ELERIX/elerix-cpm-pcb/ELERIX-CPM-Full-Image.png

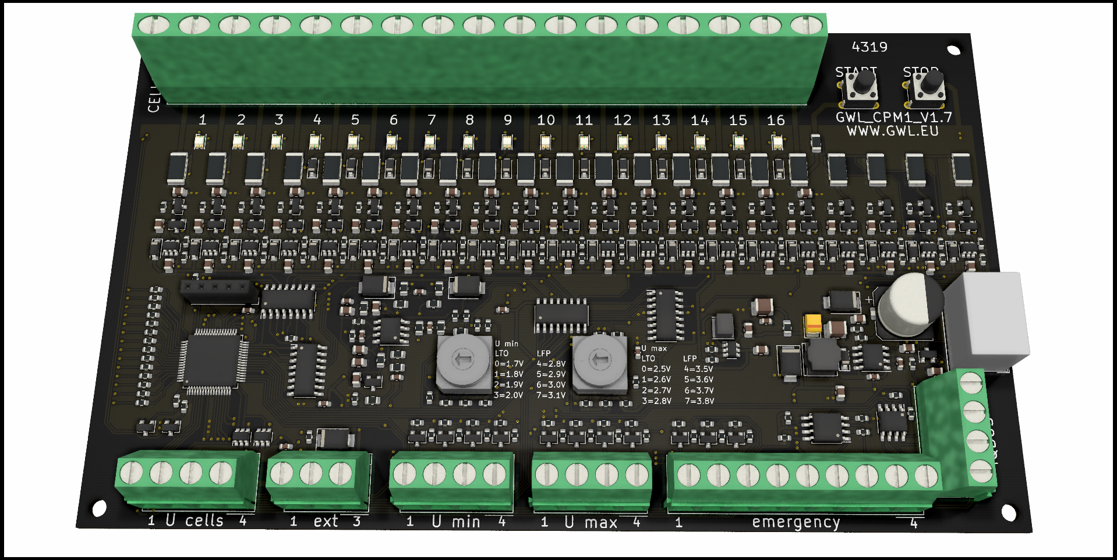
ELERIX-CPM-Full-Image.png
