ELERIX/elerix-cpm-pcb/README.md

# CPM PCB

Printed circuit board files

IDE: KiCad
