ELERIX/elerix-cpm-pcb/CE-conformity/ELERIX-CPM-EN-61000-6-4-2006-EMC-Emission.pdf

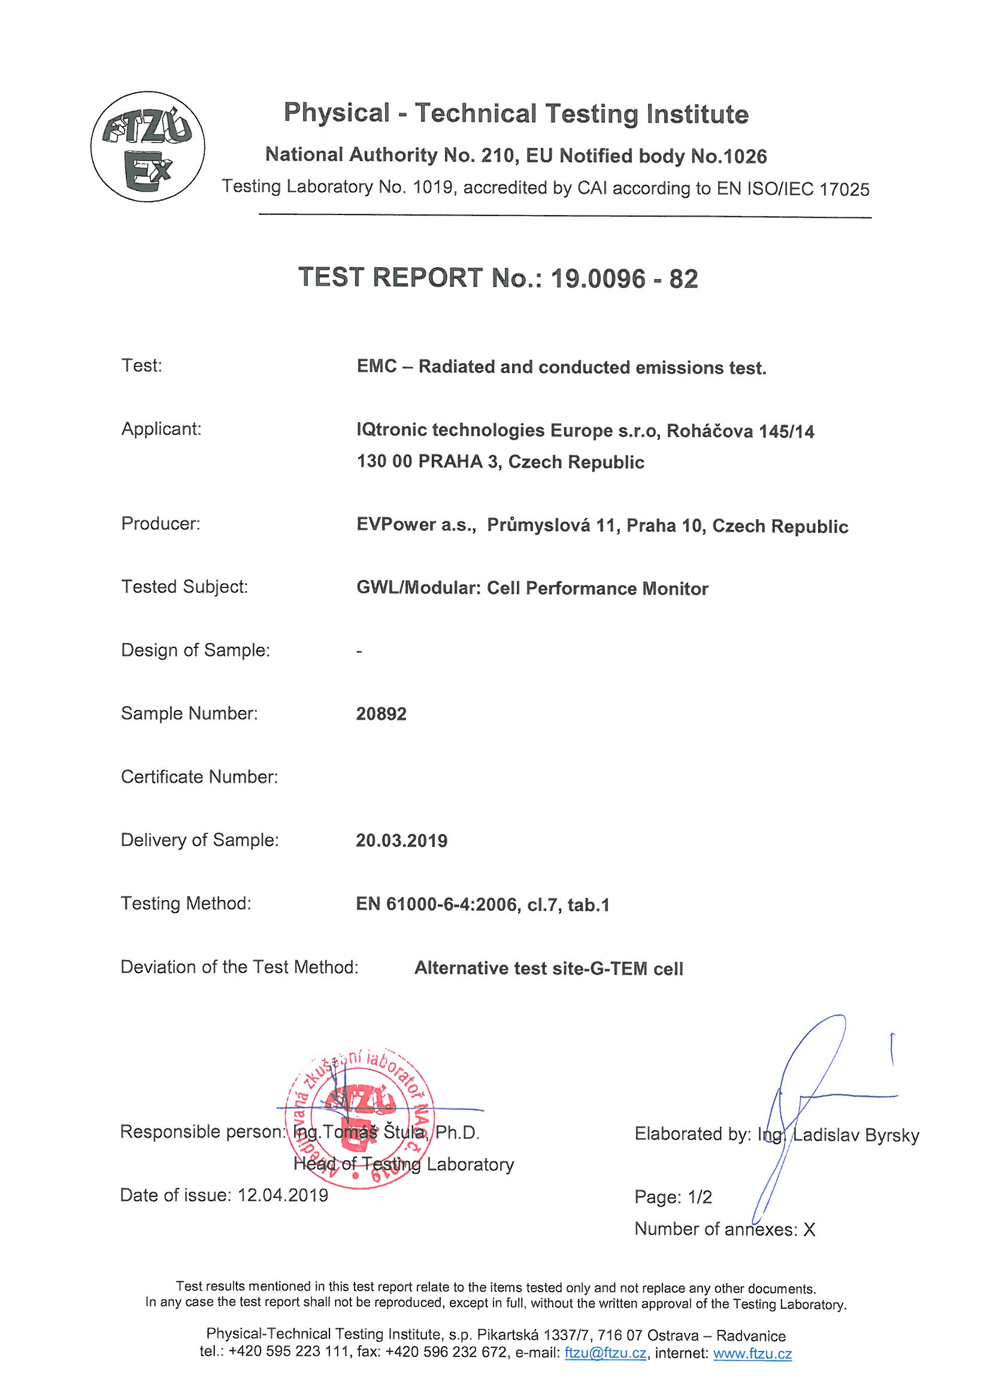
[picture p2: page 1]
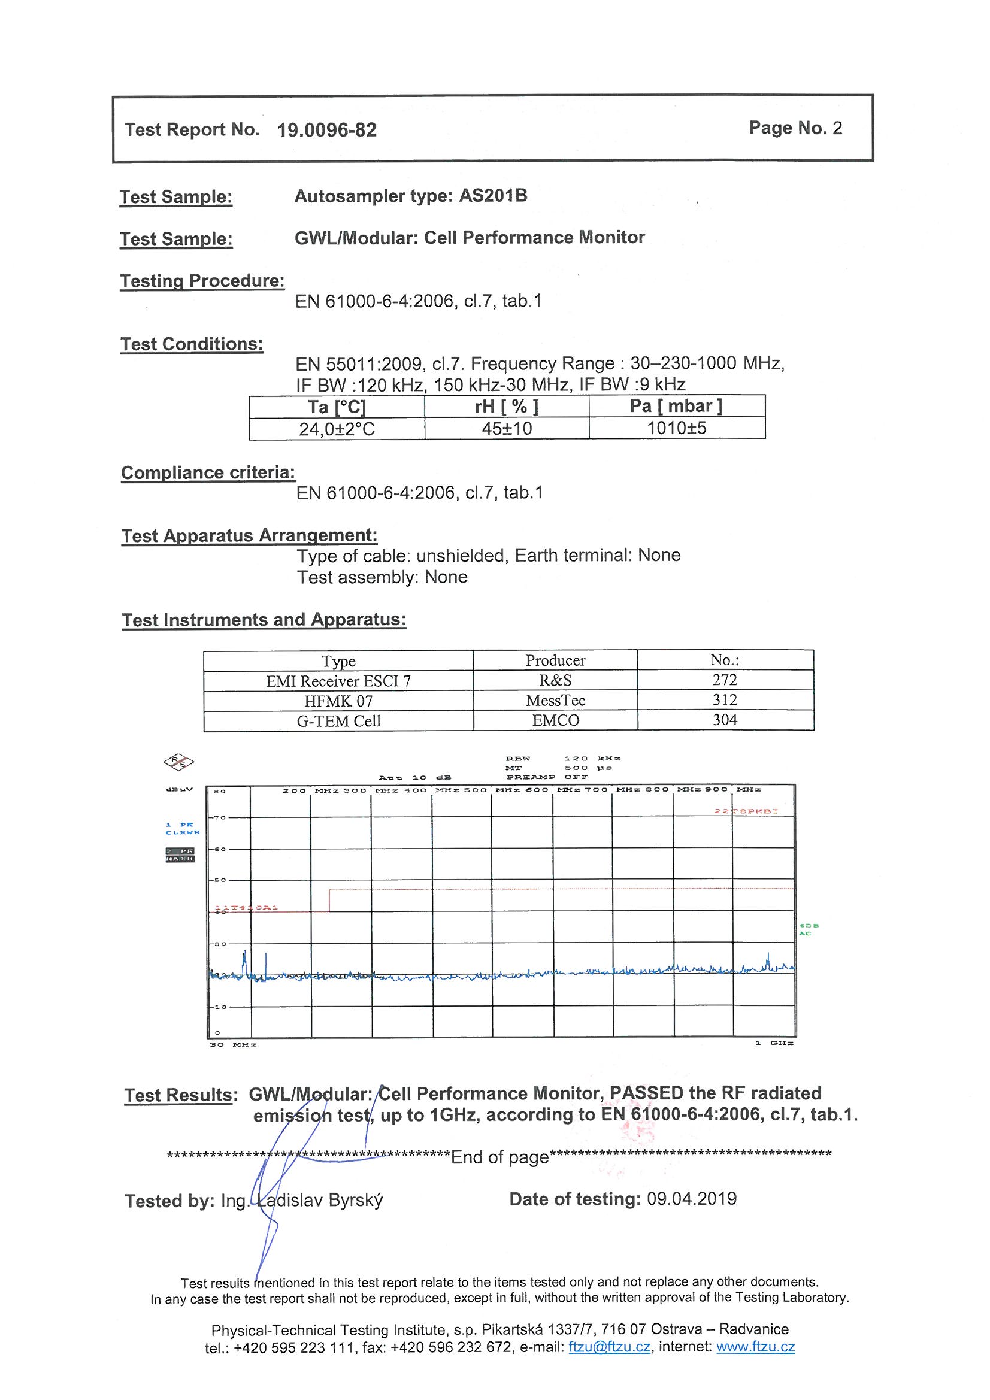
[picture p3: page 2]
