ELERIX/elerix-cpm-pcb/3D/Rotary Switch 8 positions.stp

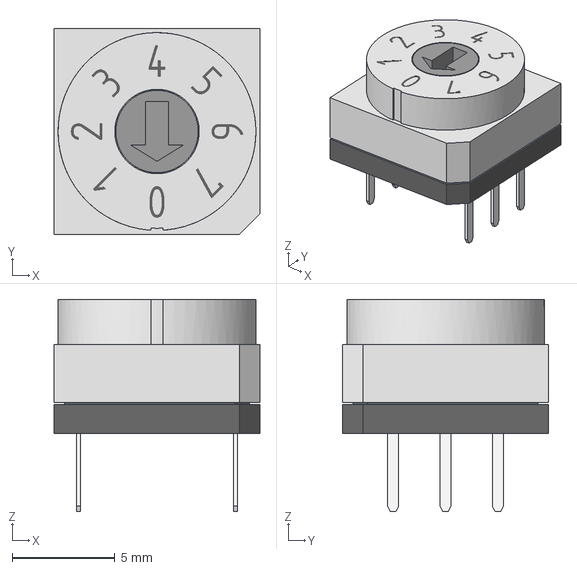
[picture p4: CAD file, 2021-03-24]
3D/Rotary Switch 8 positions.stp
10.0 x 10.0 x 10.3 mm
