ELERIX/elerix-cpm-pcb/3D/N4100CHS3DC6AC.step

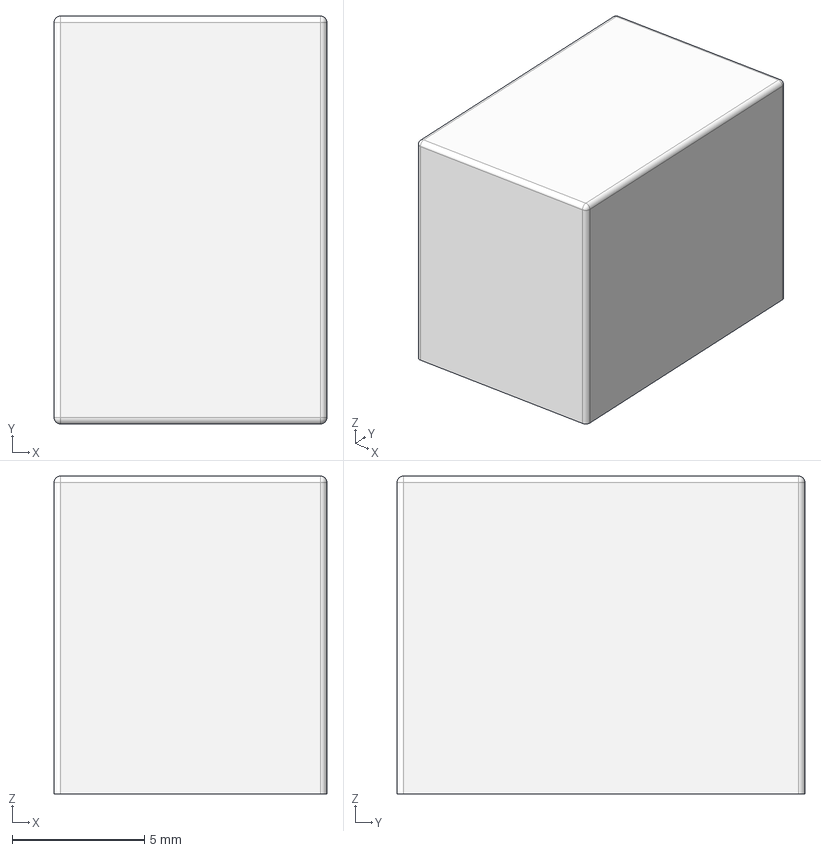
[picture p5: CAD file, 2021-03-24]
3D/N4100CHS3DC6AC.step
10.3 x 15.4 x 12.0 mm
