ELERIX/elerix-cpm-pcb/CE-conformity/ELERIX-CPM-EN-61000-4-3-2006-EMC-Immunity-Test.pdf

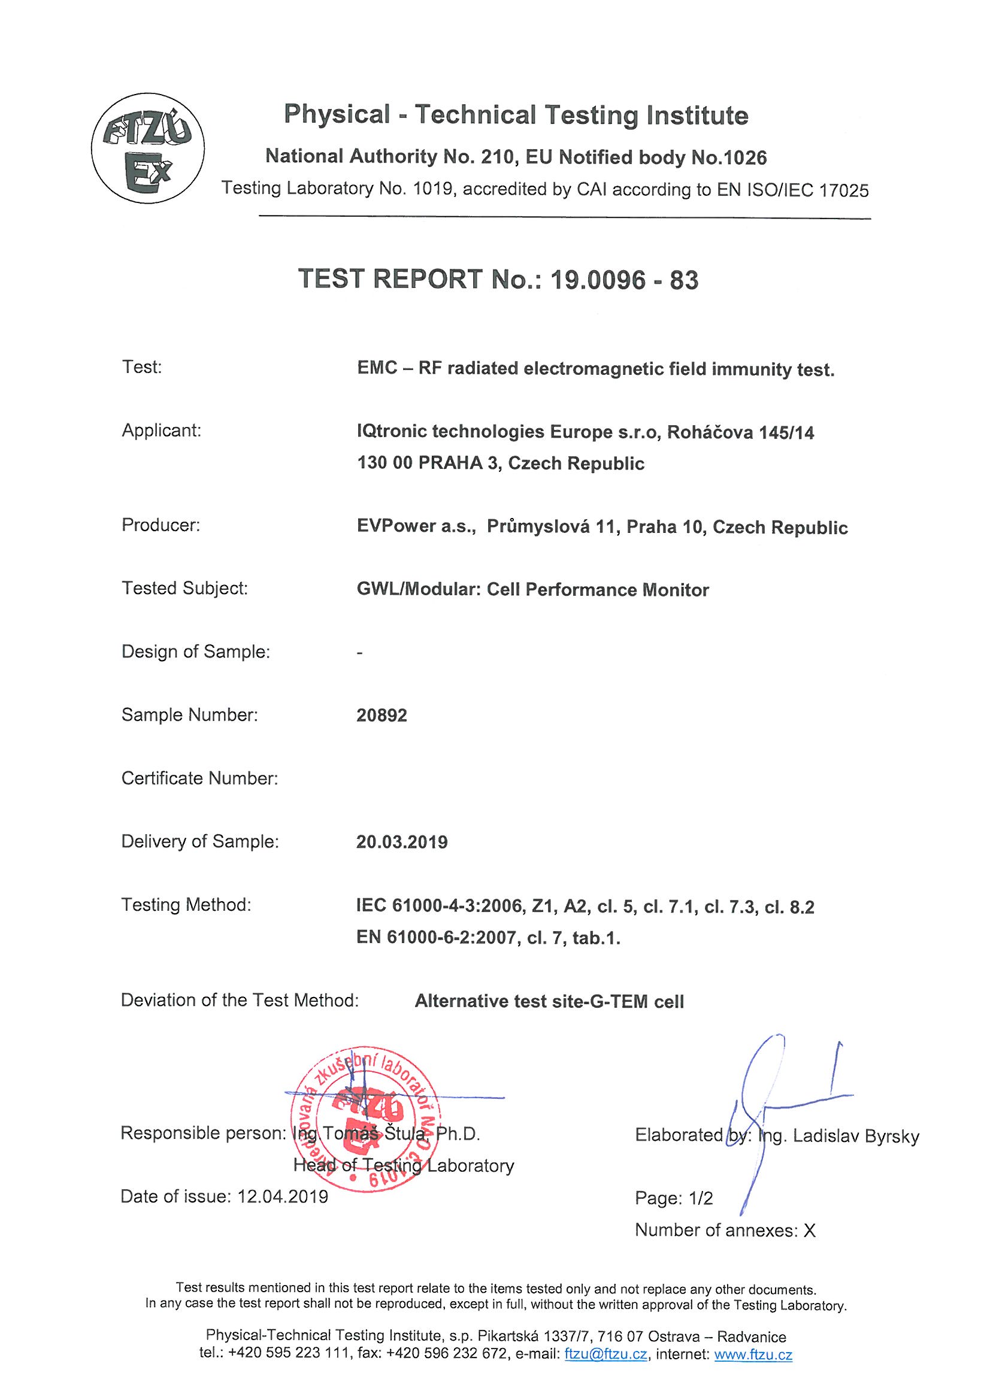
[picture p6: page 1]
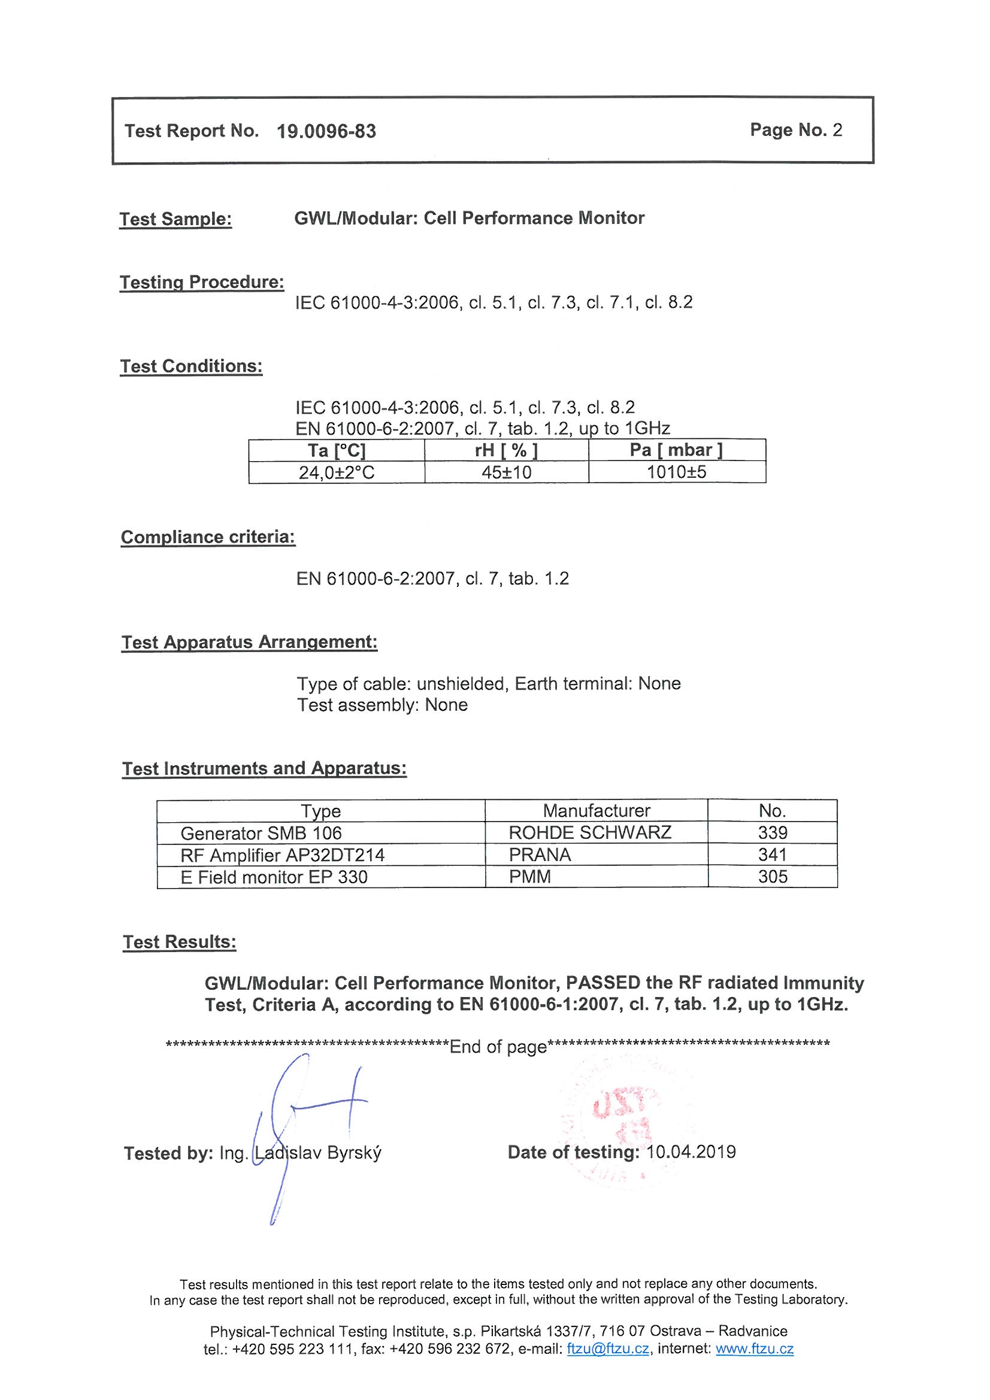
[picture p7: page 2]
