ELERIX/elerix-cpm-pcb/ELERIX-CPM_Complete-Schematic.pdf

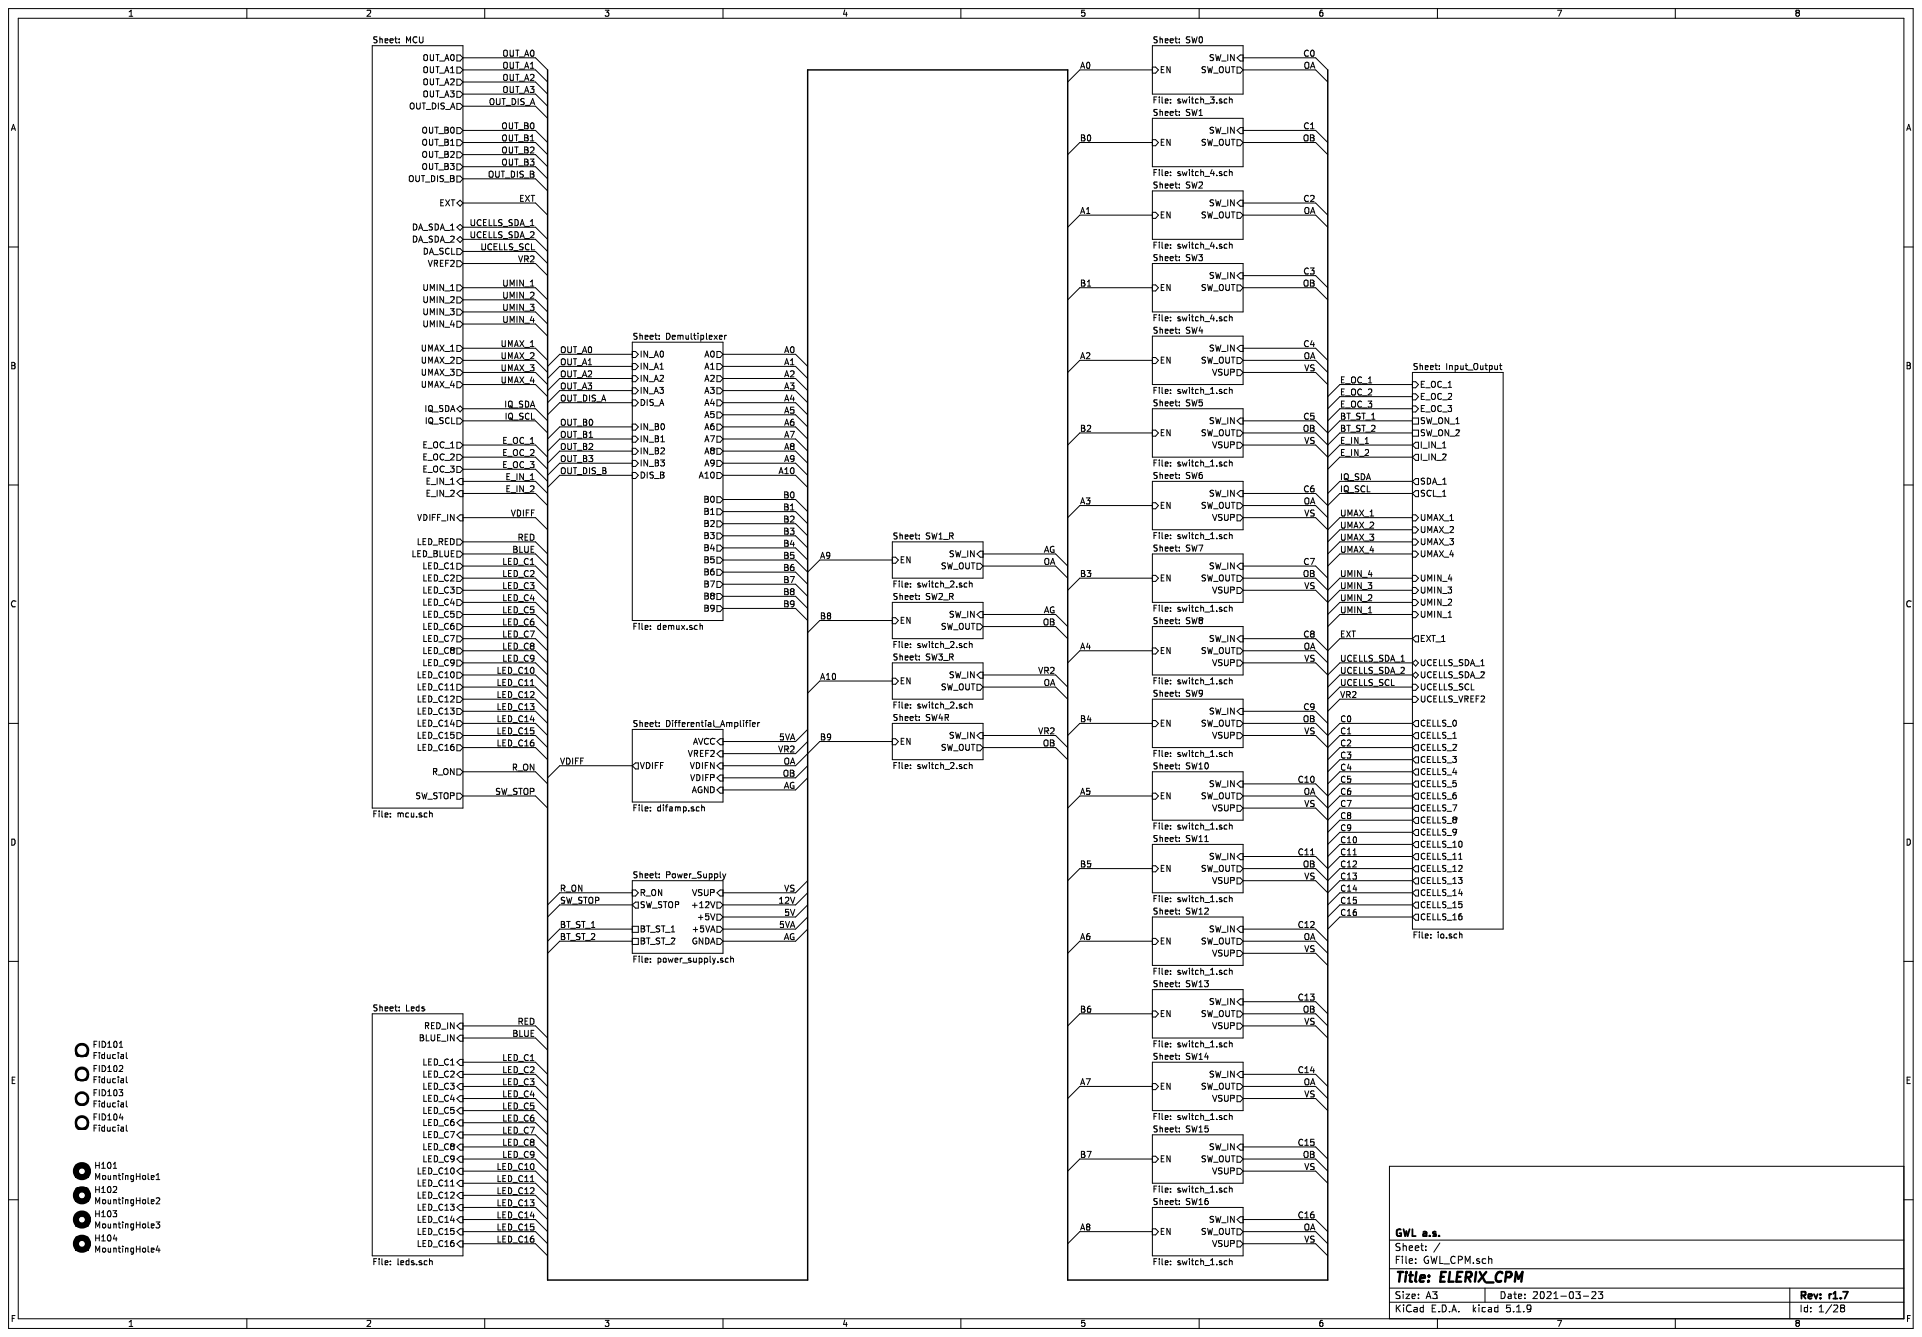
[picture p8: page 1]

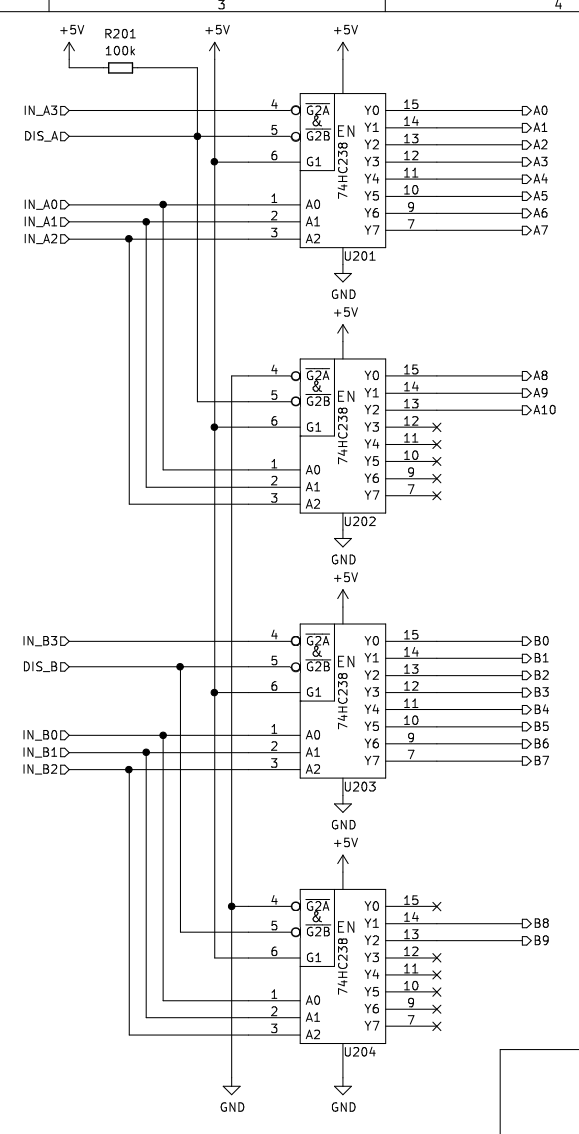
[picture p9: page 2]

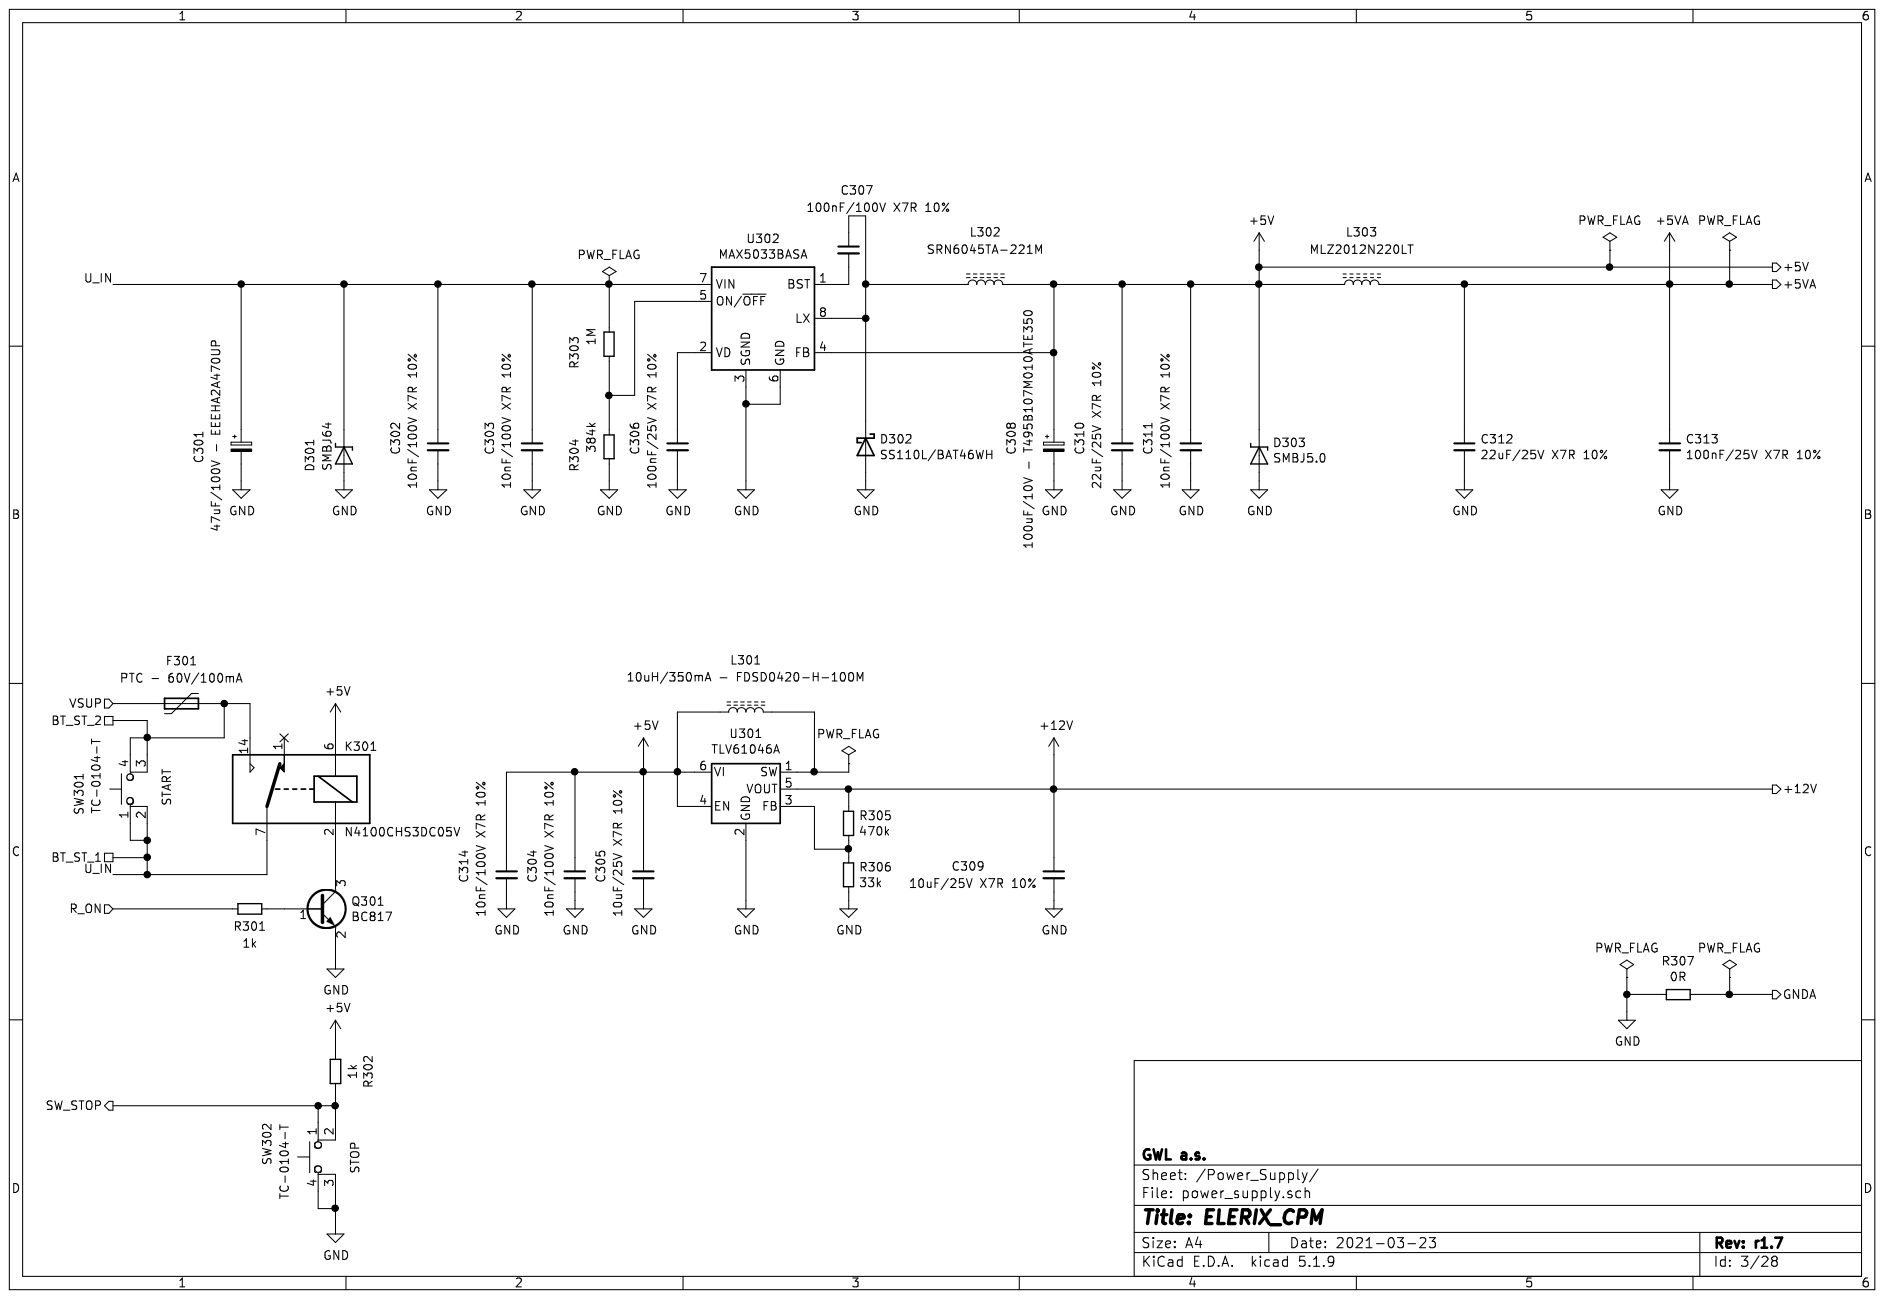
[picture p10: page 3]

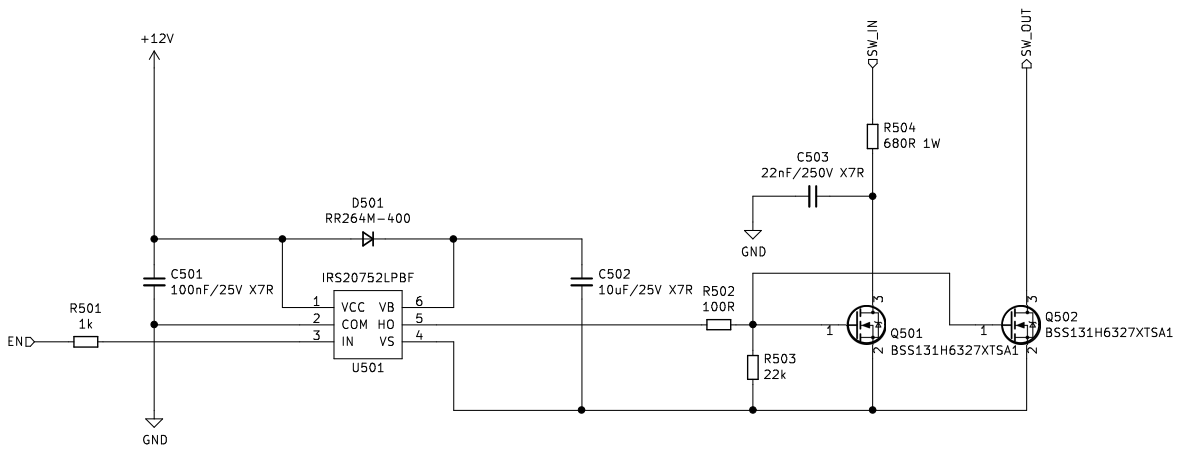
[picture p11: page 4]

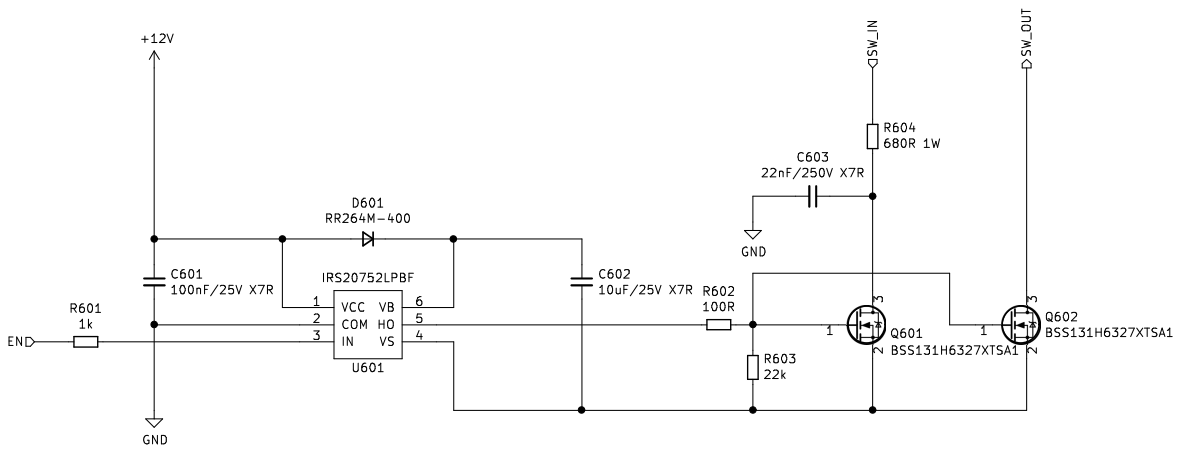
[picture p12: page 5]

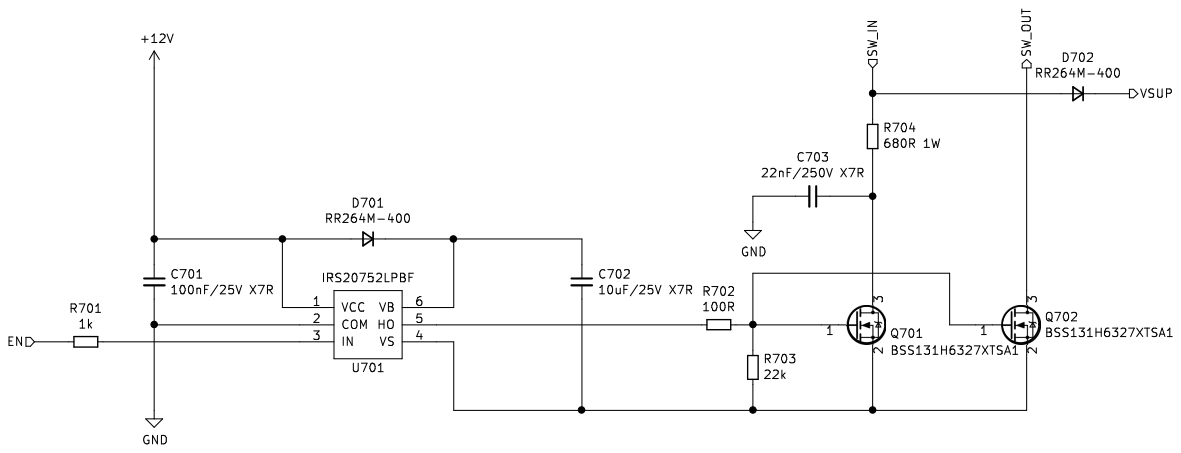
[picture p13: page 6]

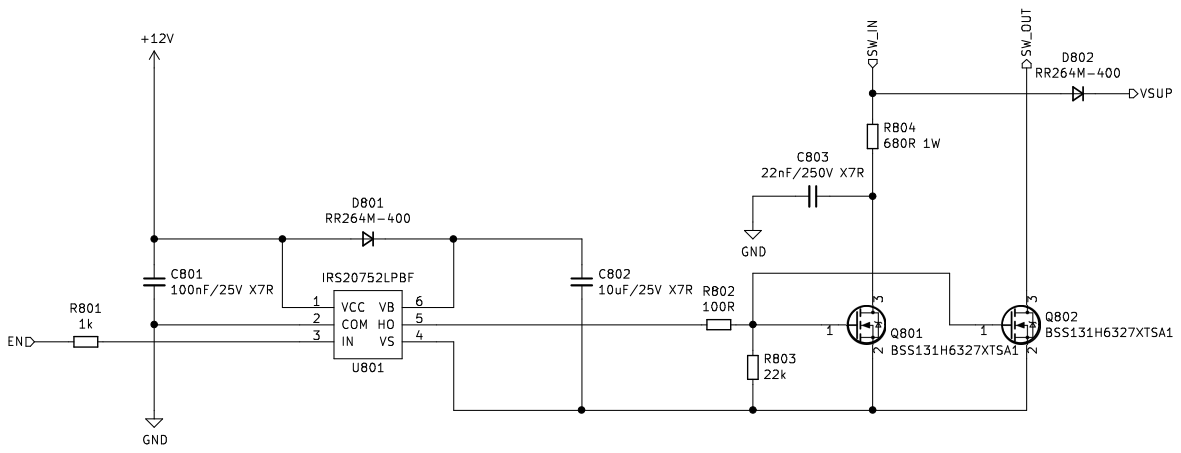
[picture p14: page 7]

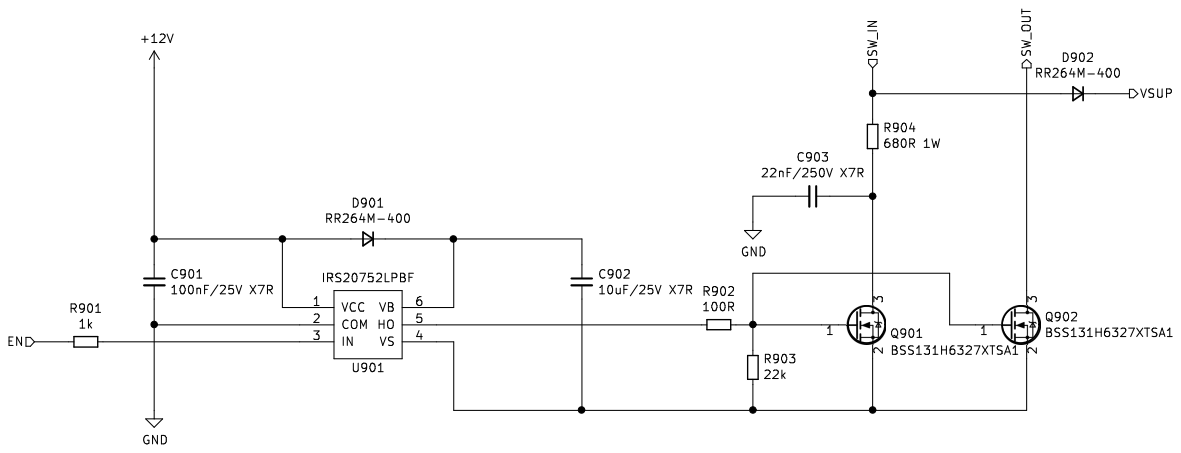
[picture p15: page 8]

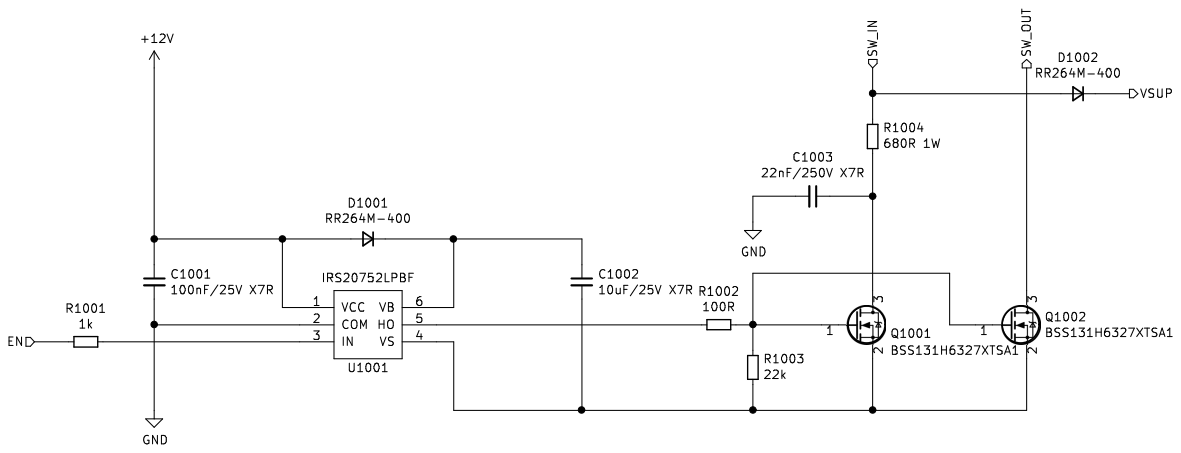
[picture p16: page 9]

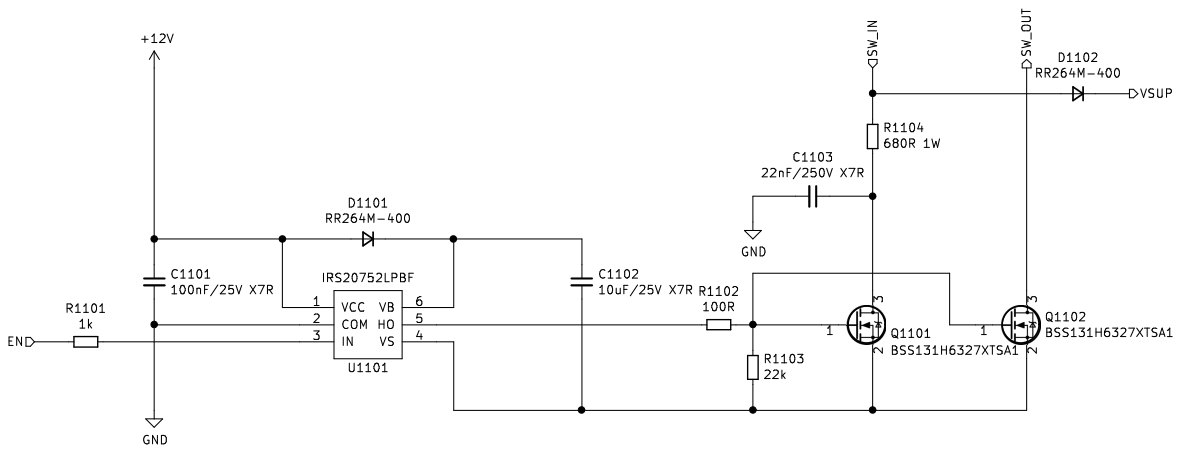
[picture p17: page 10]

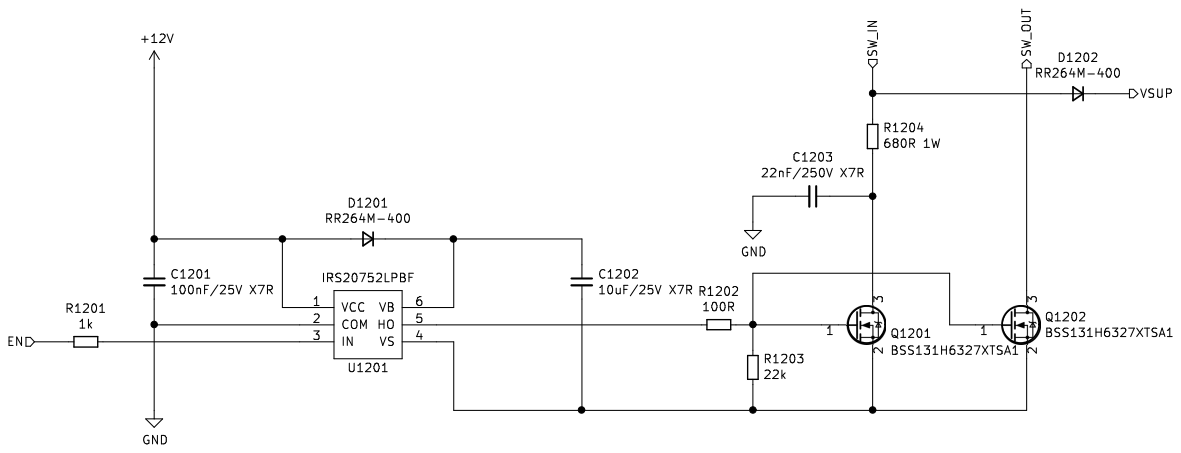
[picture p18: page 11]

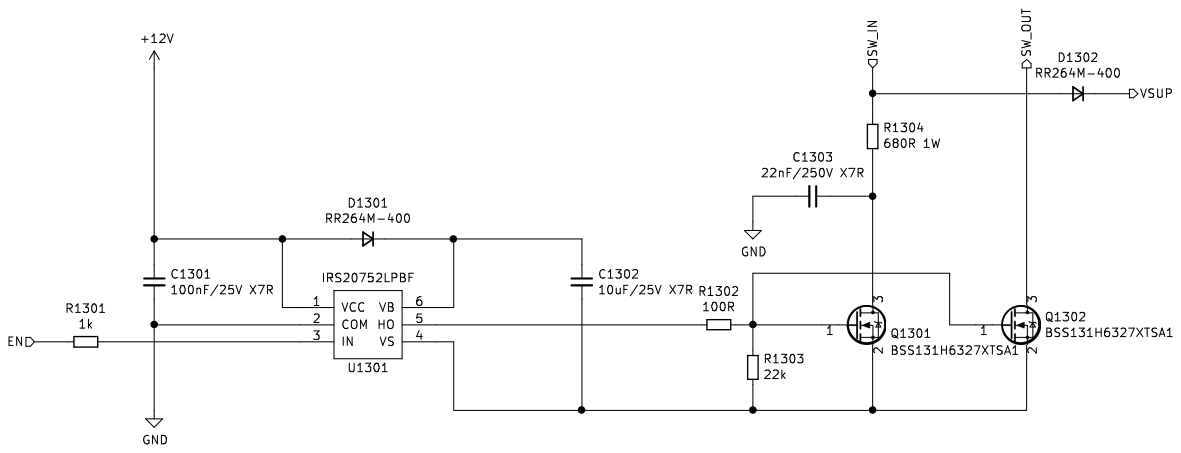
[picture p19: page 12]

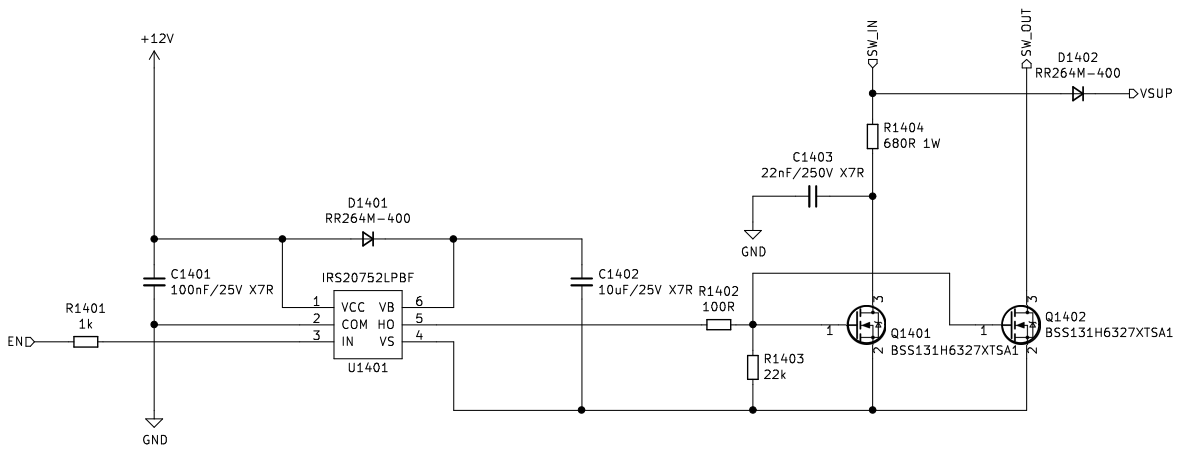
[picture p20: page 13]

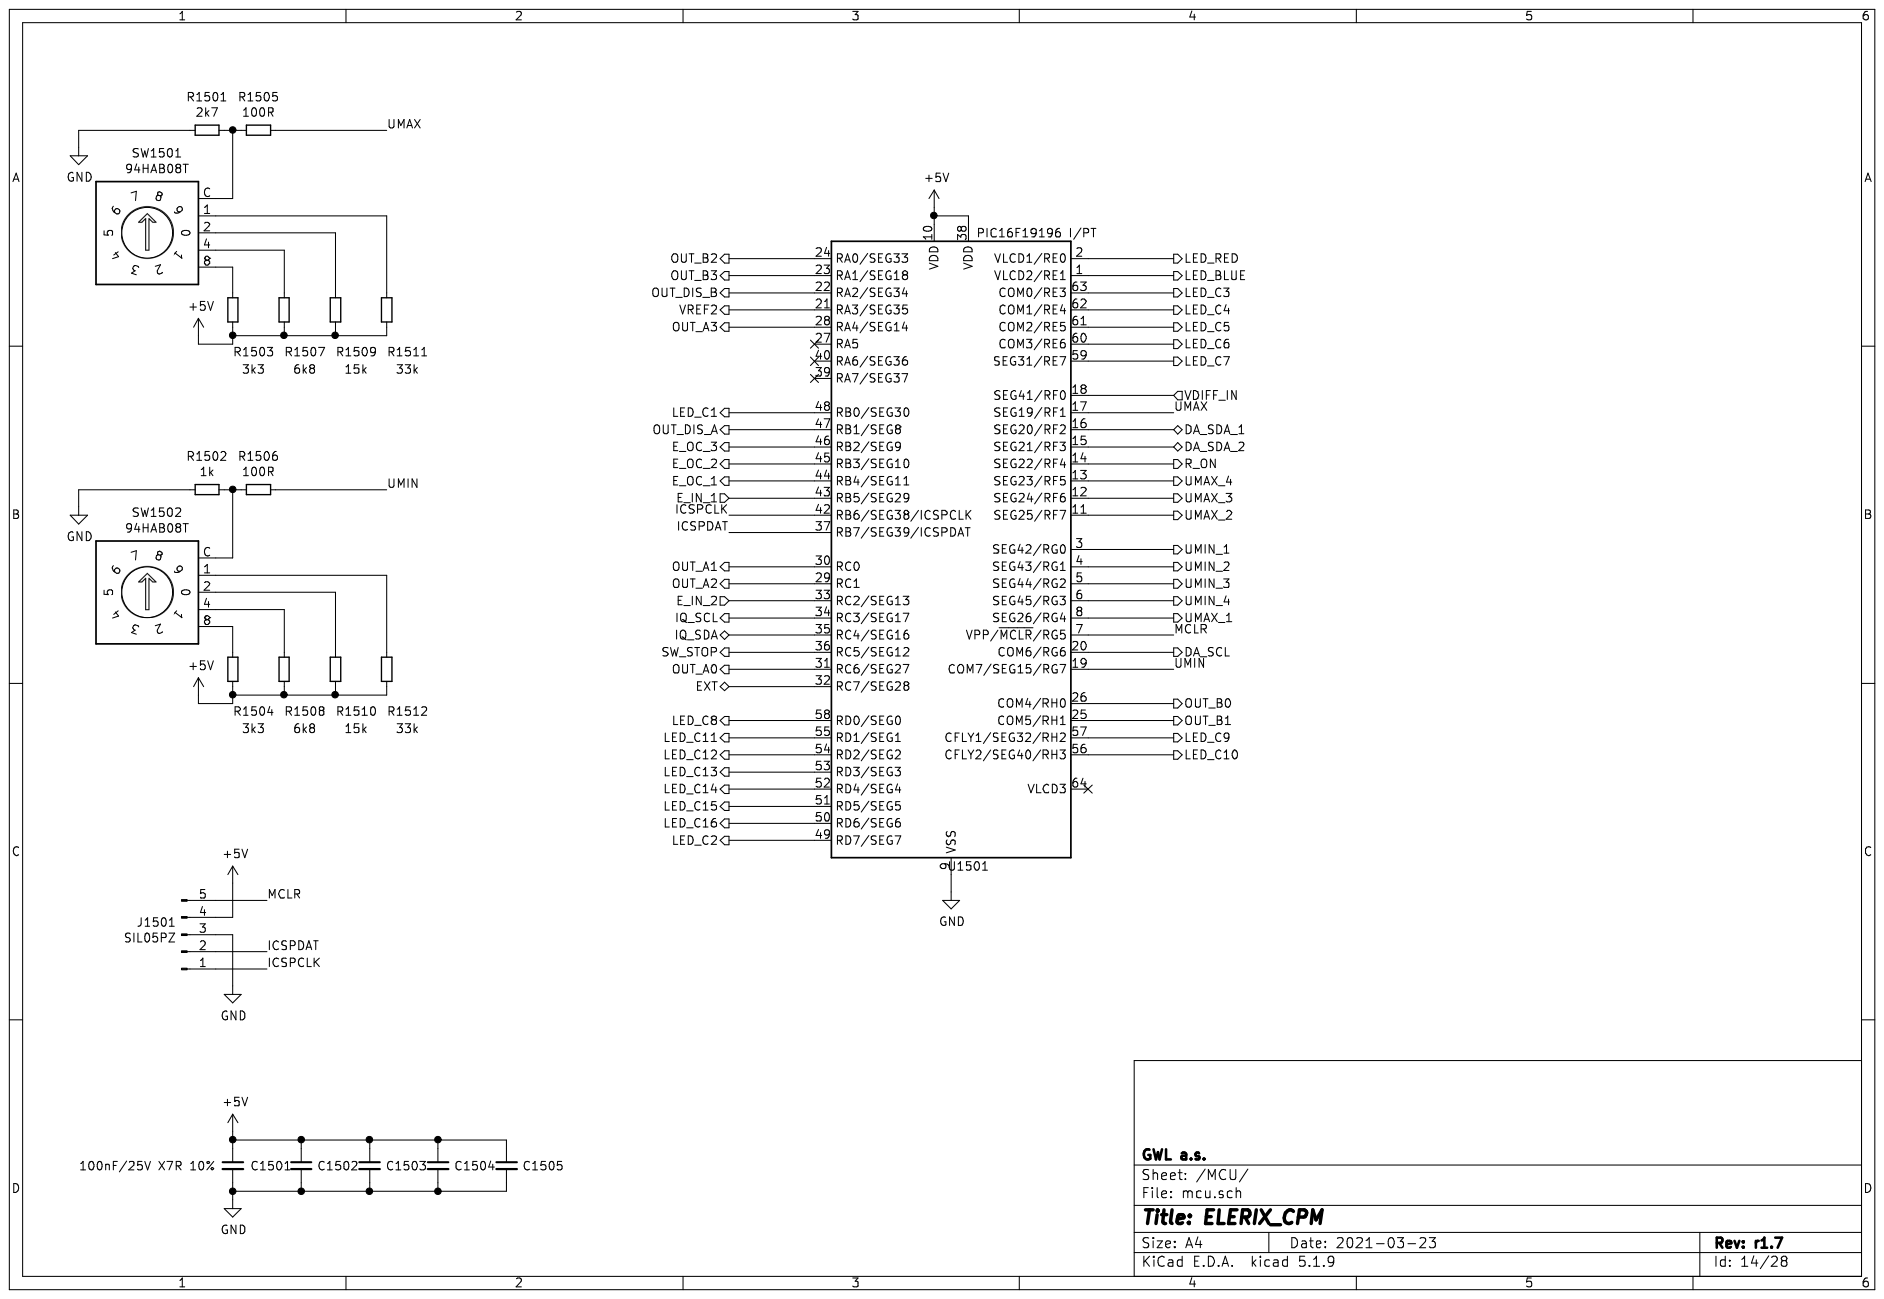
[picture p21: page 14]

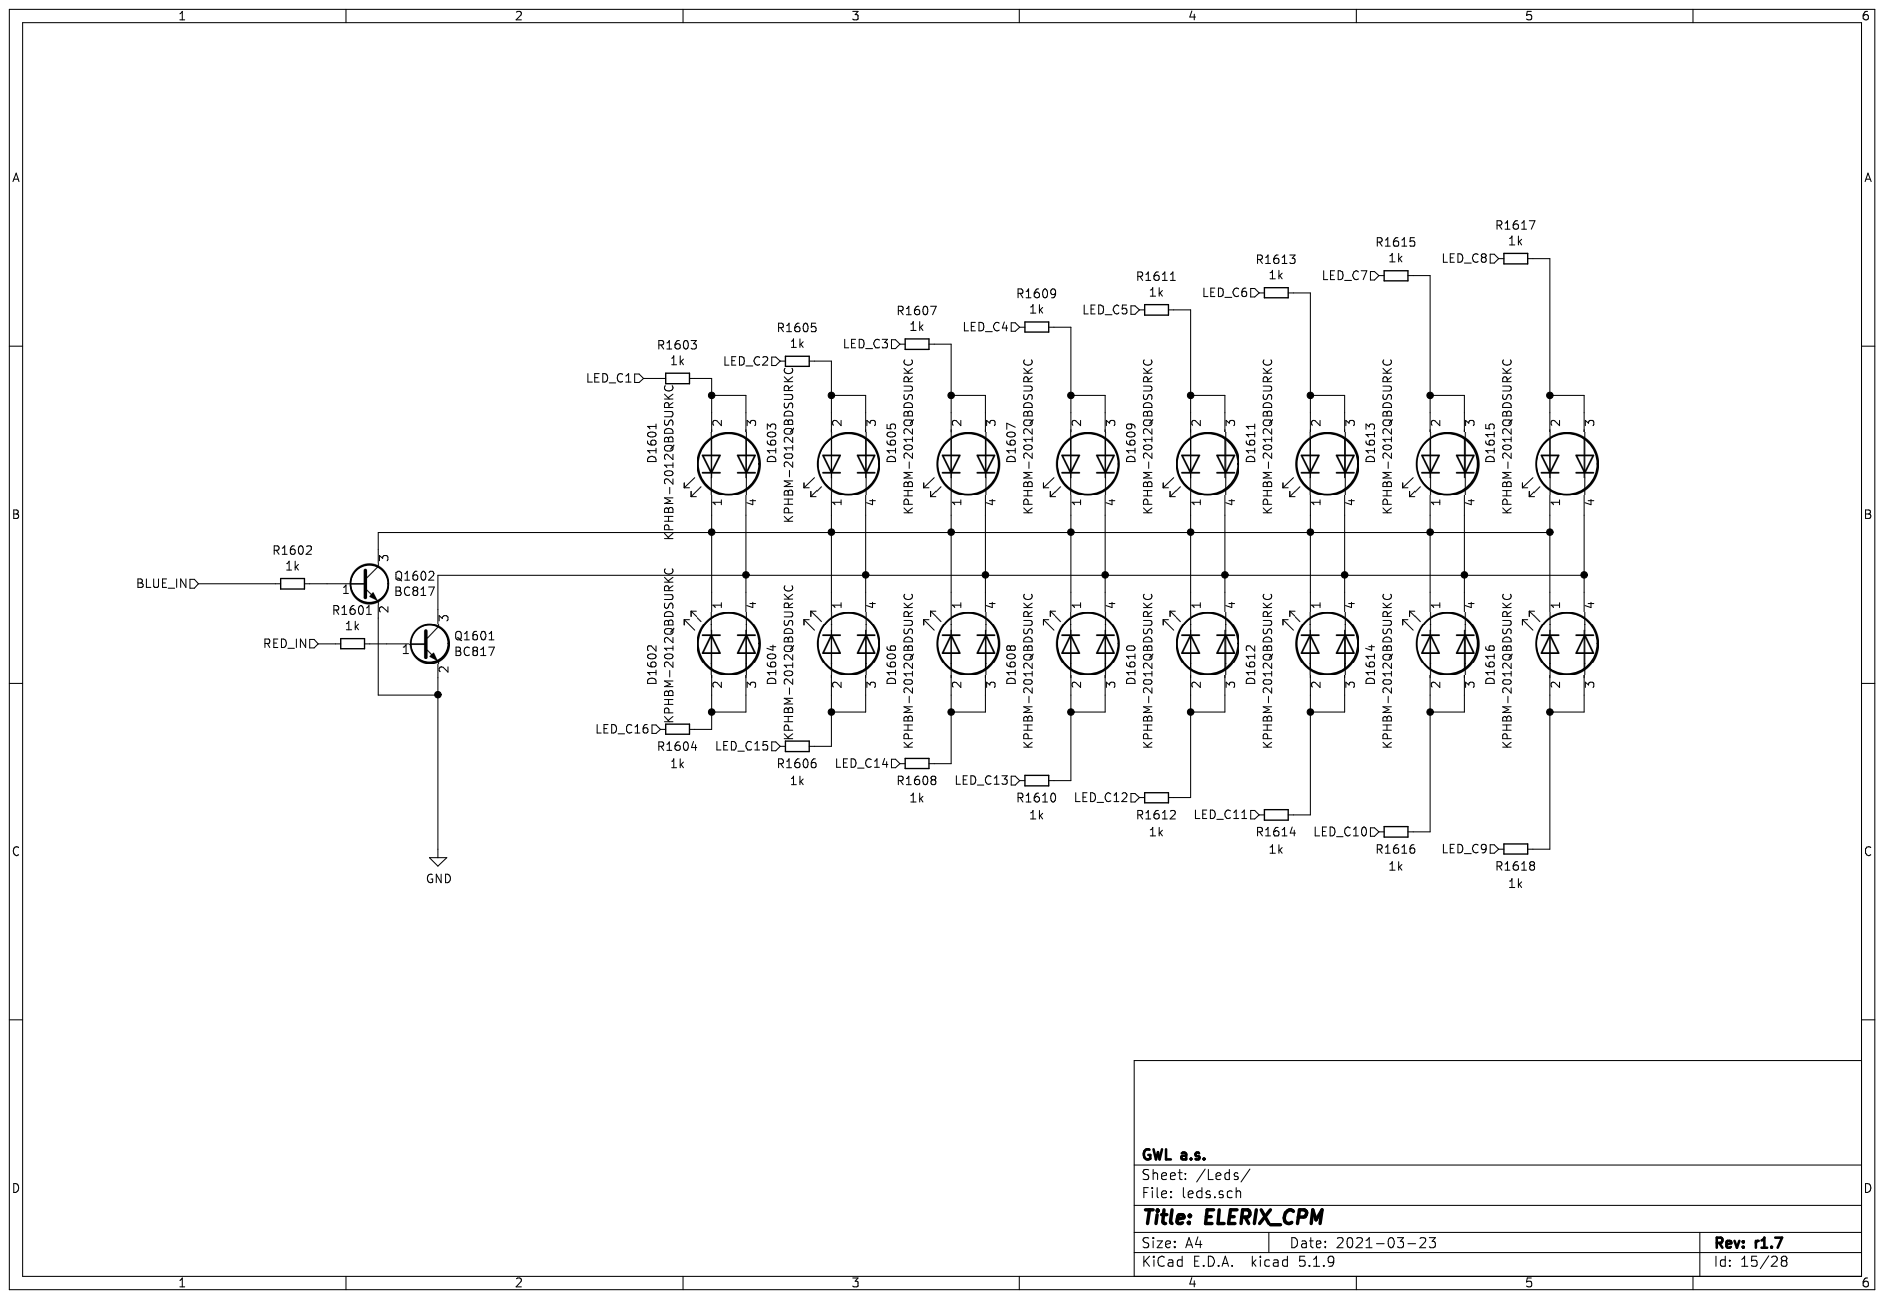
[picture p22: page 15]

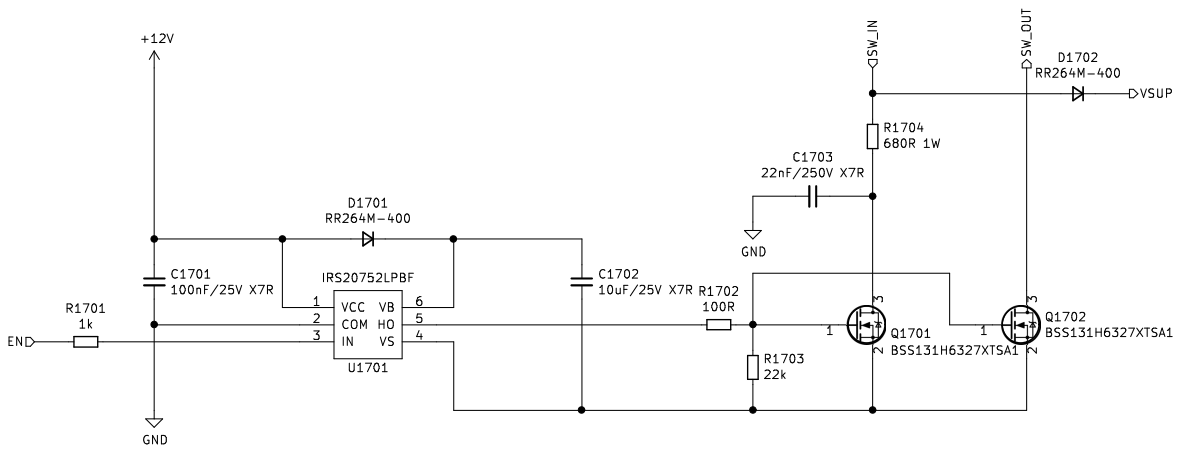
[picture p23: page 16]

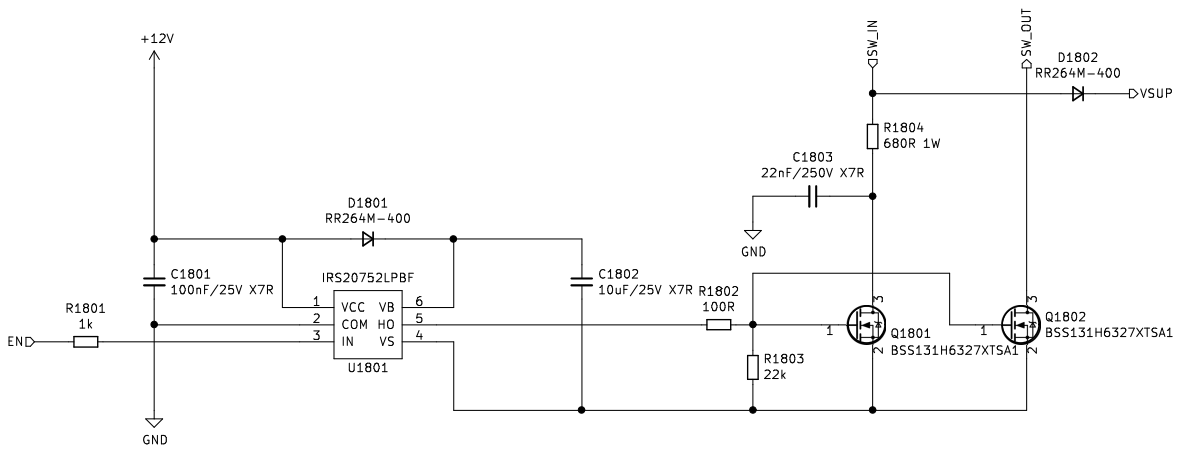
[picture p24: page 17]

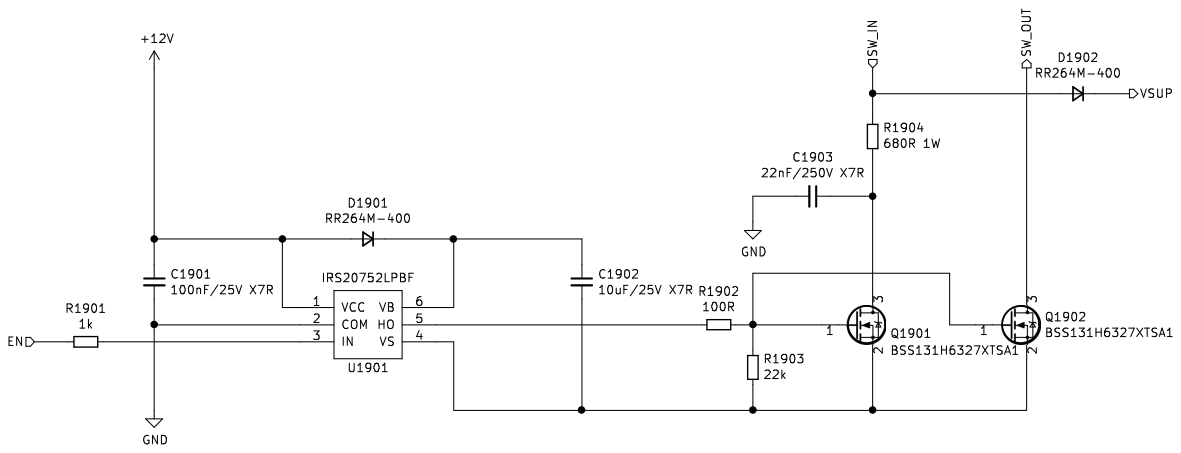
[picture p25: page 18]

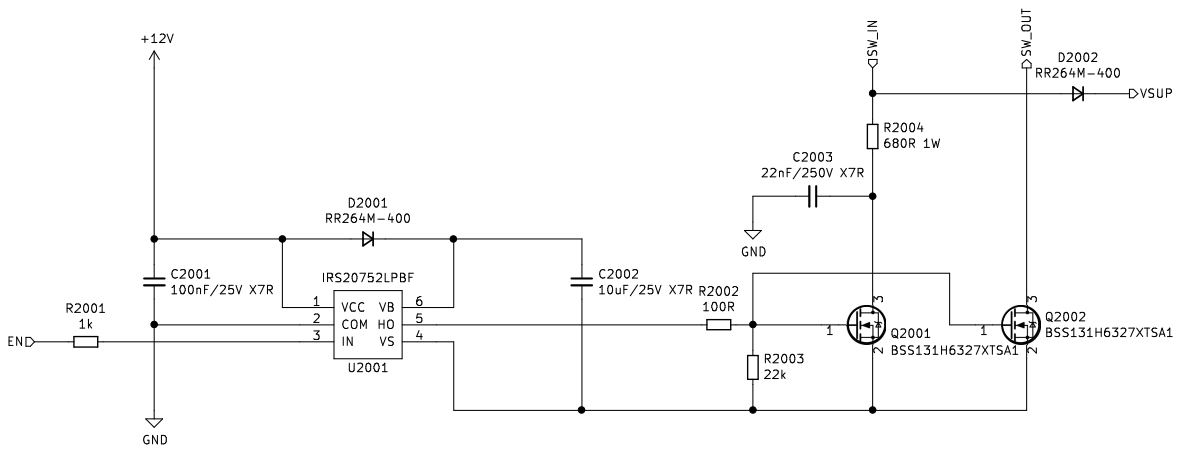
[picture p26: page 19]

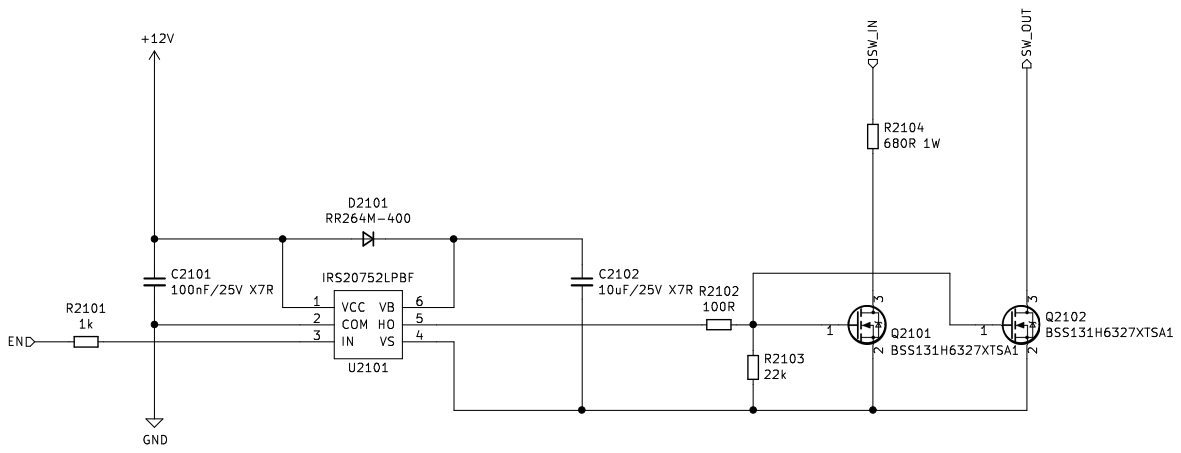
[picture p27: page 20]

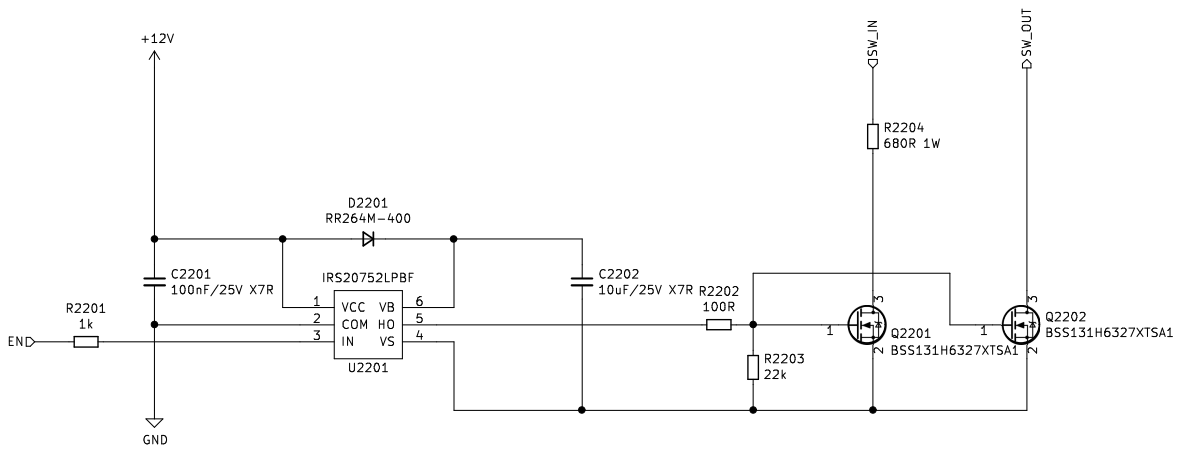
[picture p28: page 21]

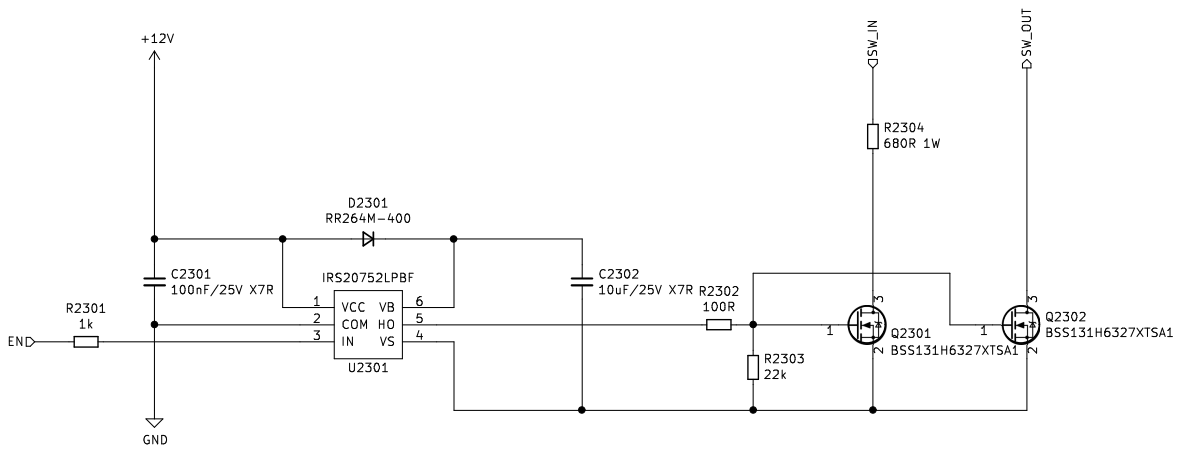
[picture p29: page 22]

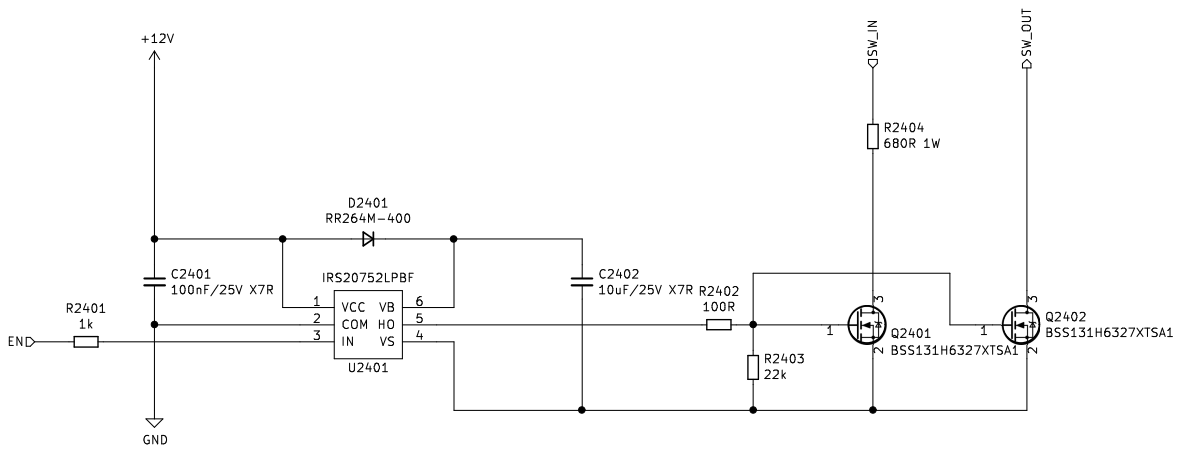
[picture p30: page 23]

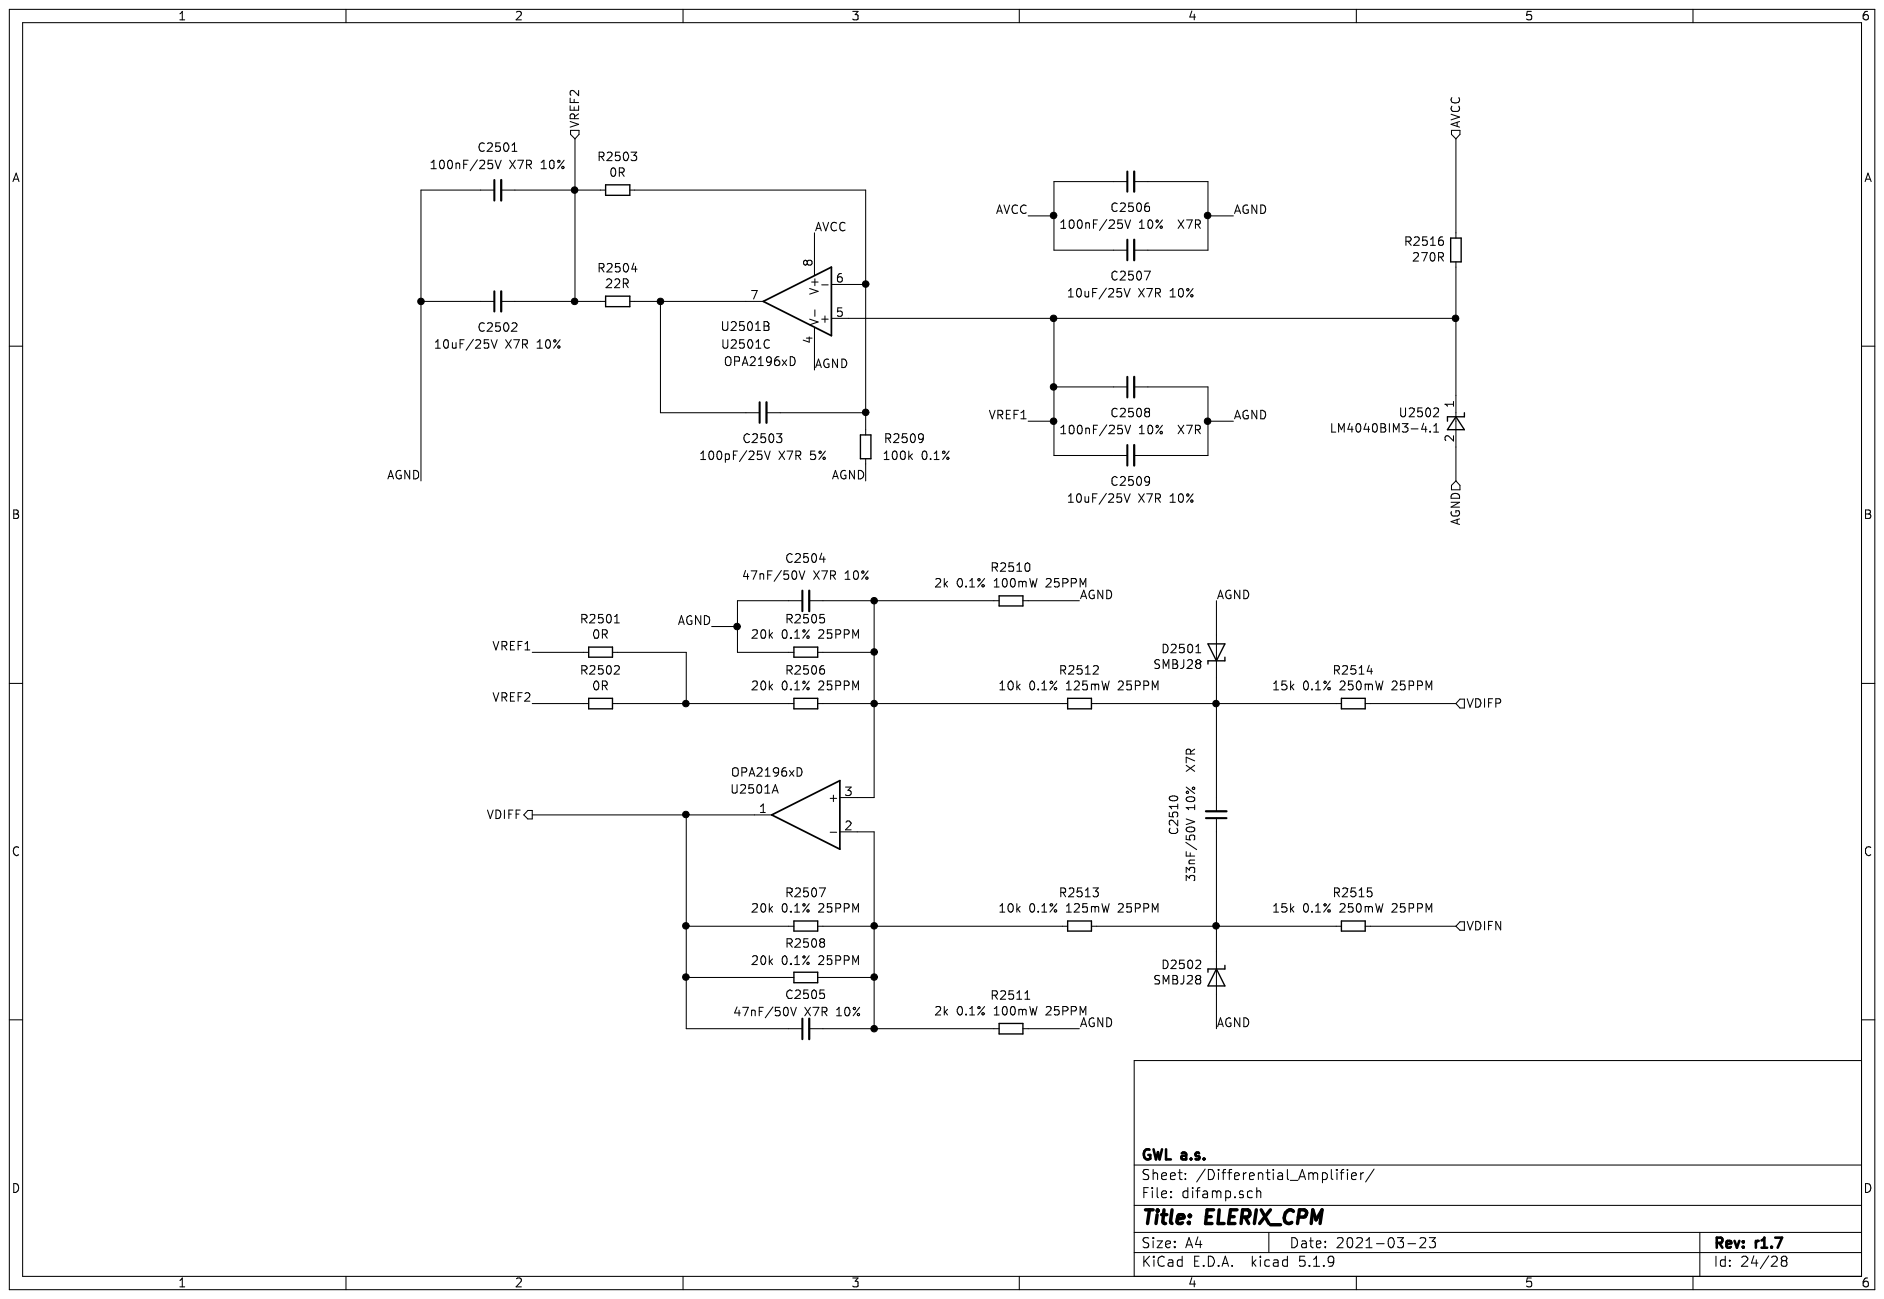
[picture p31: page 24]

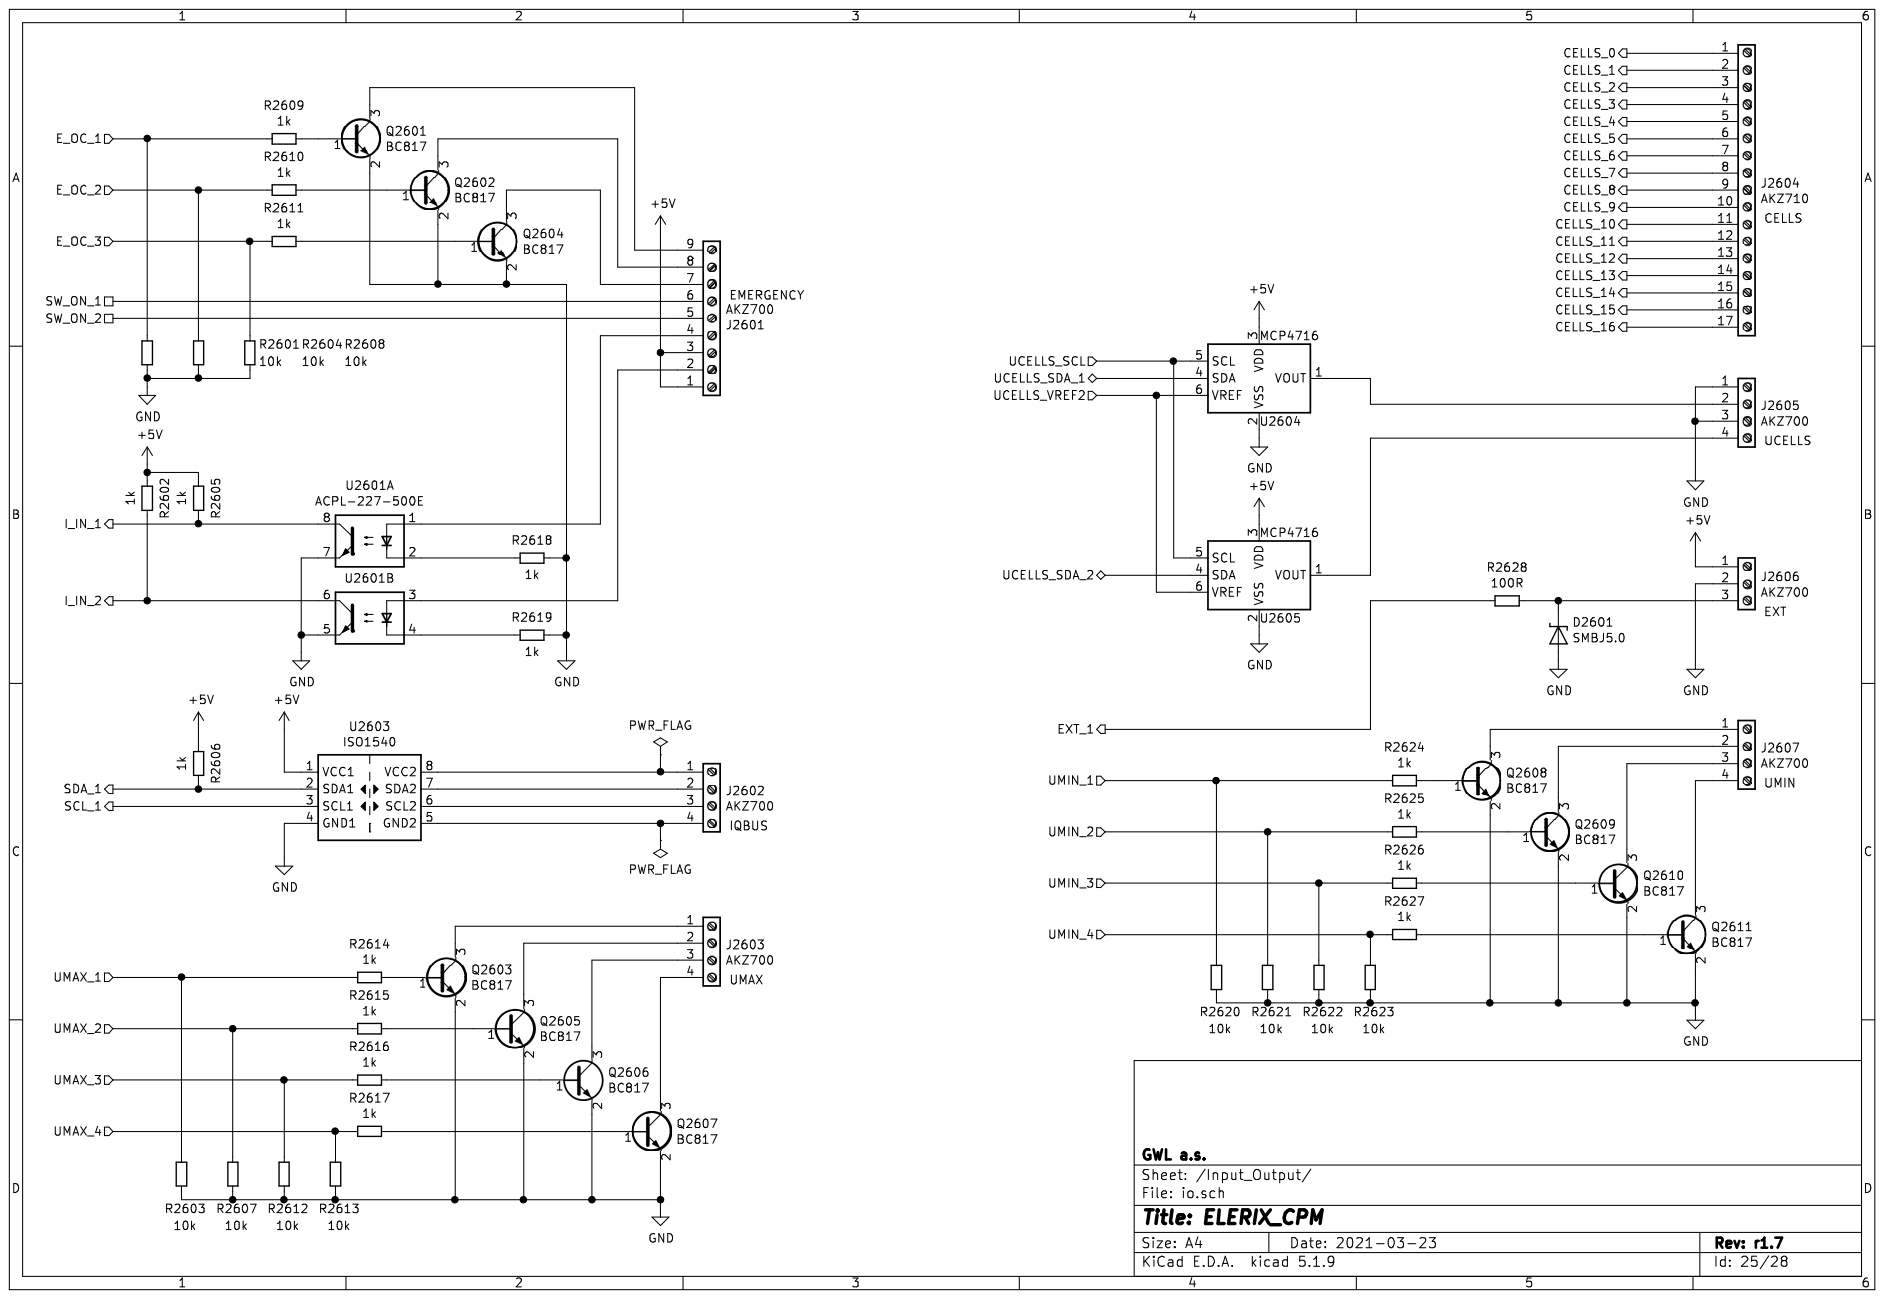
[picture p32: page 25]

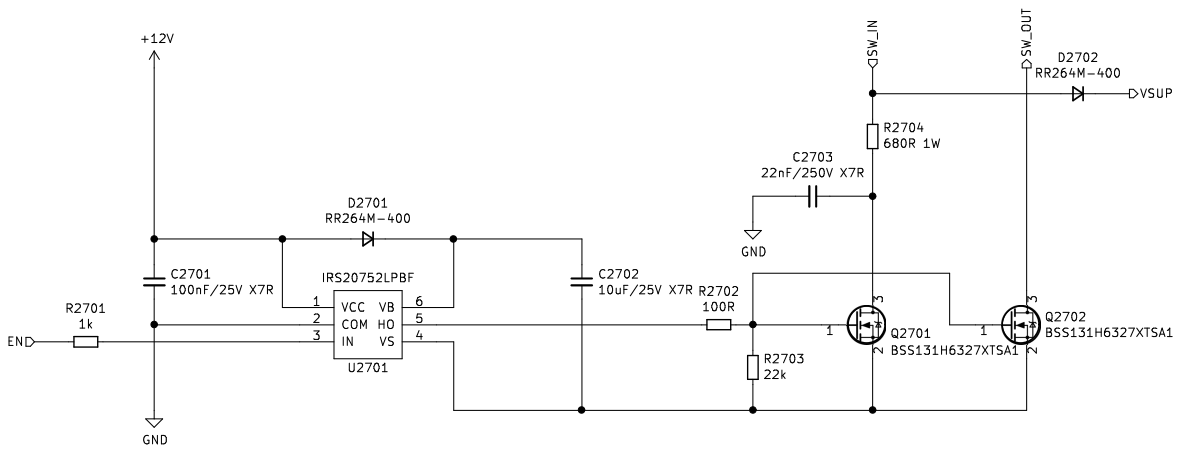
[picture p33: page 26]

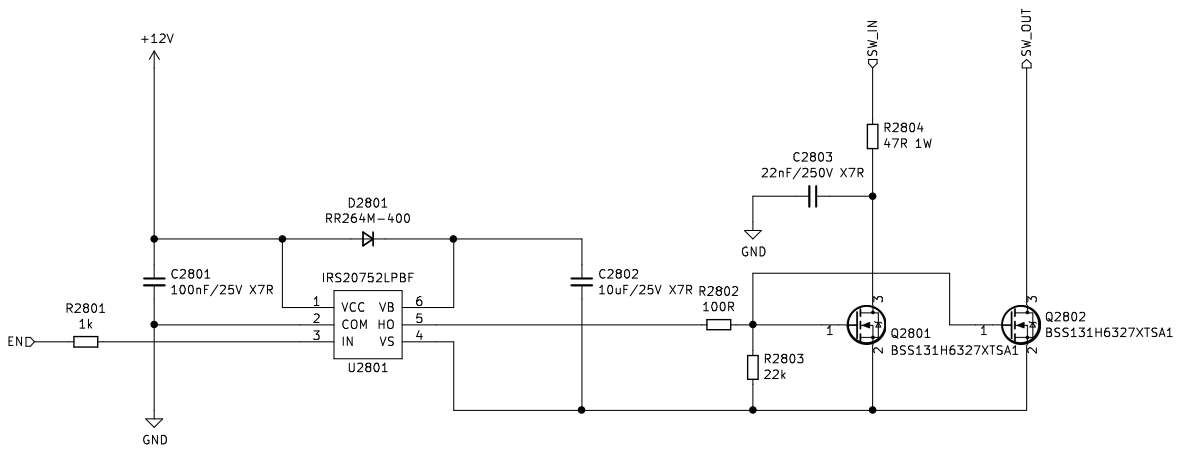
[picture p34: page 27]

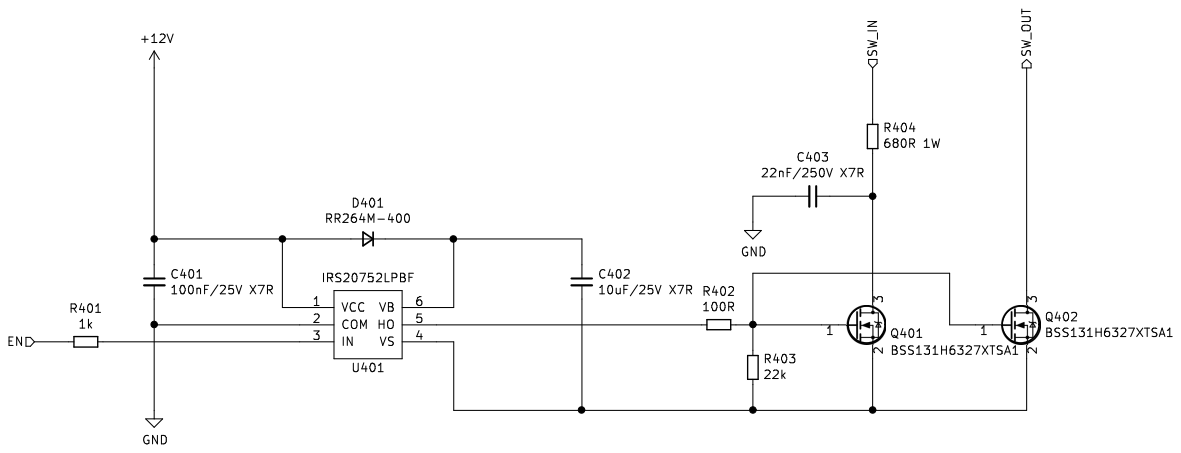
[picture p35: page 28]
