ELERIX/elerix-cpm-pcb/GWL_CPM.kicad_pcb

## KiCad design GWL_CPM.kicad_pcb (2021-03-24)

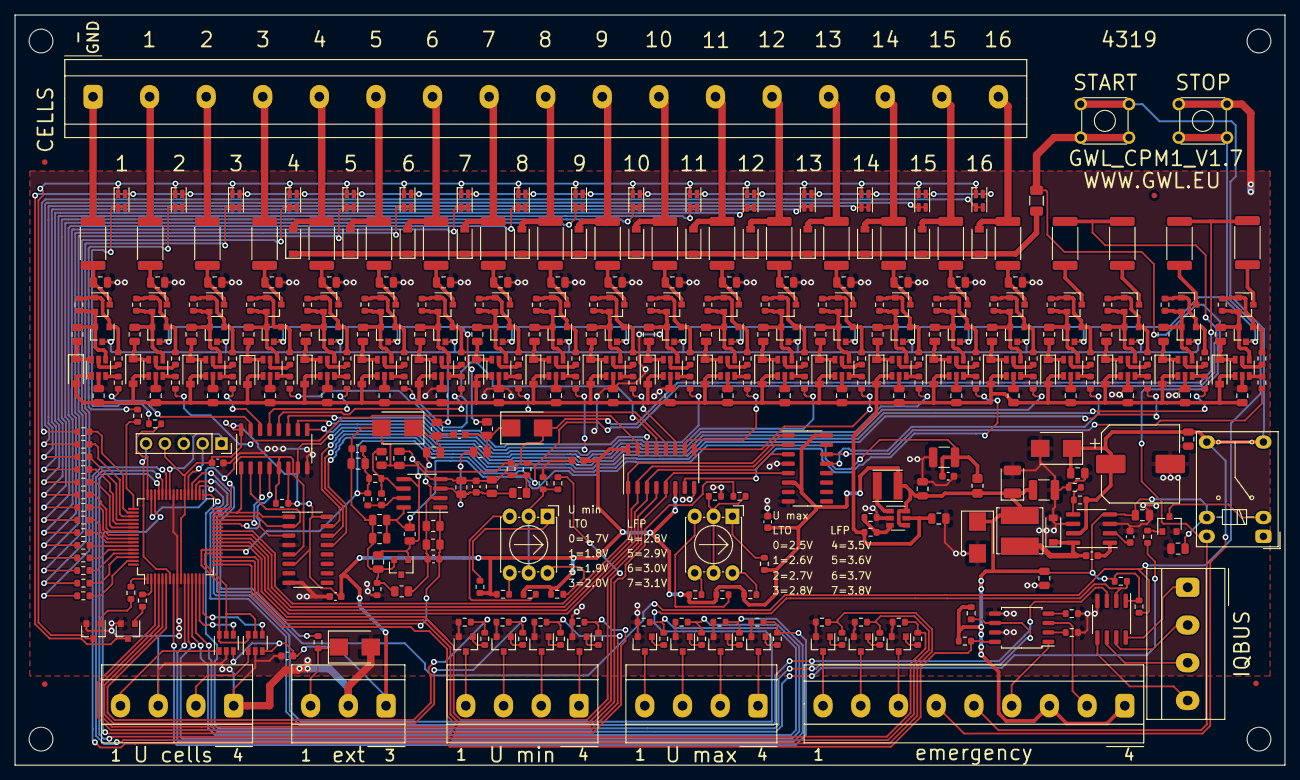
[picture p36: board GWL_CPM.kicad_pcb from above]

Board: 2 copper layers, 171.0 x 101.0 mm, 425 parts (0 on the bottom side), 309 nets.

Parts:
C301: 47uF/100V - EEEHA2A470UP; CP_Elec_10x10
C302, C303, C304, C311, C314: 10nF/100V X7R 10%; C_0805_2012Metric
C305, C309, C2502, C2507, C2509: 10uF/25V X7R 10%; C_0805_2012Metric
C306, C313, C1501, C1502, C1503, C1504, C1505, C2501: 100nF/25V X7R 10%; C_0603_1608Metric
C307: 100nF/100V X7R 10%; C_0603_1608Metric
C308: 100uF/10V - T495B107M010ATE350; CP_EIA-3528-21_Kemet-B
C310, C312: 22uF/25V X7R 10%; C_1210_3225Metric
C401, C501, C601, C701, C801, C901, C1001, C1101, C1201, C1301, C1401, C1701, C1801, C1901, C2001, C2101, C2201, C2301, C2401, C2701, C2801: 100nF/25V X7R; C_0805_2012Metric
C402, C502, C602, C702, C802, C902, C1002, C1102, C1202, C1302, C1402, C1702, C1802, C1902, C2002, C2102, C2202, C2302, C2402, C2702, C2802: 10uF/25V X7R; C_0805_2012Metric
C403, C503, C603, C703, C803, C903, C1003, C1103, C1203, C1303, C1403, C1703, C1803, C1903, C2003, C2703, C2803: 22nF/250V X7R; C_0805_2012Metric
C2503: 100pF/25V X7R 5%; C_0603_1608Metric
C2504, C2505: 47nF/50V X7R 10%; C_0603_1608Metric
C2506, C2508: 100nF/25V 10% X7R; C_0805_2012Metric
C2510: 33nF/50V 10% X7R; C_0603_1608Metric
D301: SMBJ64; D_SMB
D302: SS110L/BAT46WH; D_SOD-123
D303, D2601: SMBJ5.0; D_SMB
D401, D501, D601, D701, D702, D801, D802, D901, D902, D1001, D1002, D1101, D1102, D1201, D1202, D1301, D1302, D1401, D1402, D1701, D1702, D1801, D1802, D1901, D1902, D2001, D2002, D2101, D2201, D2301, D2401, D2701, D2702, D2801: RR264M-400; D_SOD-123
D1601, D1602, D1603, D1604, D1605, D1606, D1607, D1608, D1609, D1610, D1611, D1612, D1613, D1614, D1615, D1616: KPHBM-2012QBDSURKC
D2501, D2502: SMBJ28; D_SMB
F301: PTC - 60V/100mA; Fuse_1206_3216Metric
FID101, FID102, FID103, FID104: Fiducial; Fiducial_0.75mm_Mask1.5mm
H101: MountingHole1; MountingHole_3.2mm_M3
H102: MountingHole2; MountingHole_3.2mm_M3
H103: MountingHole3; MountingHole_3.2mm_M3
H104: MountingHole4; MountingHole_3.2mm_M3
J1501: SIL05PZ; PinSocket_1x05_P2.54mm_Vertical
J2601: AKZ700; AKZ700_9_5.08
J2602, J2603, J2605, J2607: AKZ700; AKZ700_4_5.08
J2604: AKZ710; AKZ710_17_7.62
J2606: AKZ700; AKZ700_3_5.08
K301: N4100CHS3DC05V; N4100_Relay
L301: 10uH/350mA - FDSD0420-H-100M; L_Taiyo-Yuden_MD-4040
L302: SRN6045TA-221M; L_Bourns_SRN6045TA
L303: MLZ2012N220LT; R_0805_2012Metric_Pad1.20x1.40mm_HandSolder
Q301, Q1601, Q1602, Q2601, Q2602, Q2603, Q2604, Q2605, Q2606, Q2607, Q2608, Q2609, Q2610, Q2611: BC817; SOT-23
Q401, Q402, Q501, Q502, Q601, Q602, Q701, Q702, Q801, Q802, Q901, Q902, Q1001, Q1002, Q1101, Q1102, Q1201, Q1202, Q1301, Q1302, Q1401, Q1402, Q1701, Q1702, Q1801, Q1802, Q1901, Q1902, Q2001, Q2002, Q2101, Q2102, Q2201, Q2202, Q2301, Q2302, Q2401, Q2402, Q2701, Q2702, Q2801, Q2802: BSS131H6327XTSA1; SOT-23
R201: 100k; R_0603_1608Metric
R301, R302, R401, R501, R601, R701, R801, R901, R1001, R1101, R1201, R1301, R1401, R1502, R1601, R1602, R1603, R1604, R1605, R1606, R1607, R1608, R1609, R1610, R1611, R1612, R1613, R1614, R1615, R1616, R1617, R1618, R1701, R1801, R1901, R2001, R2101, R2201, R2301, R2401, R2602, R2605, R2606, R2609, R2610, R2611, R2614, R2615, R2616, R2617, R2618, R2619, R2624, R2625, R2626, R2627, R2701, R2801: 1k; R_0603_1608Metric
R303: 1M; R_0603_1608Metric
R304: 384k; R_0603_1608Metric
R305: 470k; R_0603_1608Metric
R306, R1511, R1512: 33k; R_0603_1608Metric
R307, R2501, R2502, R2503: 0R; R_0603_1608Metric
R402, R502, R602, R702, R802, R902, R1002, R1102, R1202, R1302, R1402, R1505, R1506, R1702, R1802, R1902, R2002, R2102, R2202, R2302, R2402, R2628, R2702, R2802: 100R; R_0603_1608Metric
R403, R503, R603, R703, R803, R903, R1003, R1103, R1203, R1303, R1403, R1703, R1803, R1903, R2003, R2103, R2203, R2303, R2403, R2703, R2803: 22k; R_0603_1608Metric
R404, R504, R604, R704, R804, R904, R1004, R1104, R1204, R1304, R1404, R1704, R1804, R1904, R2004, R2104, R2204, R2304, R2404, R2704: 680R 1W; R_2512_6332Metric
R1501: 2k7; R_0603_1608Metric
R1503, R1504: 3k3; R_0603_1608Metric
R1507, R1508: 6k8; R_0603_1608Metric
R1509, R1510: 15k; R_0603_1608Metric
R2504: 22R; R_0603_1608Metric
R2505, R2506, R2507, R2508: 20k 0.1% 25PPM; R_0805_2012Metric
R2509: 100k 0.1%; R_0805_2012Metric
R2510, R2511: 2k 0.1% 100mW 25PPM; R_0805_2012Metric
R2512, R2513: 10k 0.1% 125mW 25PPM; R_0805_2012Metric
R2514, R2515: 15k 0.1% 250mW 25PPM; R_0805_2012Metric
R2516: 270R; R_0805_2012Metric
R2601, R2603, R2604, R2607, R2608, R2612, R2613, R2620, R2621, R2622, R2623: 10k; R_0603_1608Metric
R2804: 47R 1W; R_2512_6332Metric
SW301, SW302: TC-0104-T; SW_TH_Tactile_Omron_B3F-10xx
SW1501, SW1502: 94HAB08T; Nidec_Copal_SH-7010C
U201, U202, U203, U204: 74HC238; SO-16_3.9x9.9mm_P1.27mm
U301: TLV61046A; SOT-23-6
U302: MAX5033BASA; SOIC-8_3.9x4.9mm_P1.27mm
U401, U501, U601, U701, U801, U901, U1001, U1101, U1201, U1301, U1401, U1701, U1801, U1901, U2001, U2101, U2201, U2301, U2401, U2701, U2801: IRS20752LPBF; SOT-23-6
U1501: PIC16F19196 I/PT; TQFP-64_10x10mm_P0.5mm
U2501: OPA2196xD; SOIC-8_3.9x4.9mm_P1.27mm
U2502: LM4040BIM3-4.1; SOT-23
U2601: ACPL-227-500E; SOIC-8_5.23x5.23mm_P1.27mm
U2603: ISO1540; SOIC-8_3.9x4.9mm_P1.27mm
U2604, U2605: MCP4716; SOT-23-6

Connections:
+5V: C304.1, C305.1, C308.1, C310.1, C311.1, C314.1, C1501.1, C1502.1, C1503.1, C1504.1, C1505.1, D303.1, J1501.4, J2601.1, J2601.3, J2606.1, K301.6, L301.1, L302.2, L303.1, R201.2, R302.2, R1503.1, R1504.1, R1507.1, R1508.1, R1509.1, R1510.1, R1511.1, R1512.1, R2602.1, R2605.1, R2606.1, U201.6, U201.16, U202.6, U202.16, U203.6, U203.16, U204.6, U204.16, U301.4, U301.6, U302.4, U1501.10, U1501.38, U2603.1, U2604.3, U2605.3
+5VA: C312.1, C313.1, C2506.1, C2507.1, L303.2, R2516.2, U2501.8
+12V: C309.1, C401.1, C501.1, C601.1, C701.1, C801.1, C901.1, C1001.1, C1101.1, C1201.1, C1301.1, C1401.1, C1701.1, C1801.1, C1901.1, C2001.1, C2101.1, C2201.1, C2301.1, C2401.1, C2701.1, C2801.1, D401.2, D501.2, D601.2, D701.2, D801.2, D901.2, D1001.2, D1101.2, D1201.2, D1301.2, D1401.2, D1701.2, D1801.2, D1901.2, D2001.2, D2101.2, D2201.2, D2301.2, D2401.2, D2701.2, D2801.2, R305.1, U301.5, U401.1, U501.1, U601.1, U701.1, U801.1, U901.1, U1001.1, U1101.1, U1201.1, U1301.1, U1401.1, U1701.1, U1801.1, U1901.1, U2001.1, U2101.1, U2201.1, U2301.1, U2401.1, U2701.1, U2801.1
/A0: R2801.2, U201.15
/A1: R501.2, U201.14
/A2: R701.2, U201.13
/A3: R901.2, U201.12
/A4: R1101.2, U201.11
/A5: R1301.2, U201.10
/A6: R2001.2, U201.9
/A7: R1801.2, U201.7
/A8: R2701.2, U202.15
/A9: R2401.2, U202.14
/A10: R2201.2, U202.13
/AG: C2501.1, C2502.1, C2504.1, C2506.2, C2507.2, C2508.2, C2509.2, D2501.2, D2502.2, R307.1, R2304.2, R2404.2, R2505.1, R2509.2, R2510.2, R2511.2, U2501.4, U2502.2
/B0: R401.2, U203.15
/B1: R601.2, U203.14
/B2: R801.2, U203.13
/B3: R1001.2, U203.12
/B4: R1201.2, U203.11
/B5: R1401.2, U203.10
/B6: R1901.2, U203.9
/B7: R1701.2, U203.7
/B8: R2301.2, U204.14
/B9: R2101.2, U204.13
/BLUE: R1602.2, U1501.1
/BT_ST_1: C301.1, C302.1, C303.1, D301.1, J2601.6, K301.7, K301.8, R303.2, SW301.1, SW301.2, U302.7
/BT_ST_2: F301.1, J2601.5, K301.14, SW301.3, SW301.4
/C0: J2604.1, R2804.2
/C1: J2604.2, R404.2
/C2: J2604.3, R504.2
/C3: J2604.4, R604.2
/C4: D702.2, J2604.5, R704.2
/C5: D802.2, J2604.6, R804.2
/C6: D902.2, J2604.7, R904.2
/C7: D1002.2, J2604.8, R1004.2
/C8: D1102.2, J2604.9, R1104.2
/C9: D1202.2, J2604.10, R1204.2
/C10: D1302.2, J2604.11, R1304.2
/C11: D1402.2, J2604.12, R1404.2
/C12: D2002.2, J2604.13, R2004.2
/C13: D1902.2, J2604.14, R1904.2
/C14: D1802.2, J2604.15, R1804.2
/C15: D1702.2, J2604.16, R1704.2
/C16: D2702.2, J2604.17, R2704.2
/Differential_Amplifier/VREF1: C2508.1, C2509.1, R2501.1, R2516.1, U2501.5, U2502.1
/EXT: R2628.2, U1501.32
/E_IN_1: R2605.2, U1501.43, U2601.8
/E_IN_2: R2602.2, U1501.33, U2601.6
/E_OC_1: R2601.1, R2609.2, U1501.44
/E_OC_2: R2604.1, R2610.2, U1501.45
/E_OC_3: R2608.1, R2611.2, U1501.46
/IQ_SCL: U1501.34, U2603.3
/IQ_SDA: R2606.2, U1501.35, U2603.2
/LED_C1: R1603.2, U1501.48
/LED_C2: R1605.2, U1501.49
/LED_C3: R1607.2, U1501.63
/LED_C4: R1609.2, U1501.62
/LED_C5: R1611.2, U1501.61
/LED_C6: R1613.2, U1501.60
/LED_C7: R1615.2, U1501.59
/LED_C8: R1617.2, U1501.58
/LED_C9: R1618.2, U1501.57
/LED_C10: R1616.2, U1501.56
/LED_C11: R1614.2, U1501.55
/LED_C12: R1612.2, U1501.54
/LED_C13: R1610.2, U1501.53
/LED_C14: R1608.2, U1501.52
/LED_C15: R1606.2, U1501.51
/LED_C16: R1604.2, U1501.50
/MCU/ICSPCLK: J1501.1, U1501.42
/MCU/ICSPDAT: J1501.2, U1501.37
/MCU/MCLR: J1501.5, U1501.7
/MCU/UMAX: R1505.1, U1501.17
/MCU/UMIN: R1506.1, U1501.19
/OA: Q502.3, Q702.3, Q902.3, Q1102.3, Q1302.3, Q1802.3, Q2002.3, Q2202.3, Q2402.3, Q2702.3, Q2802.3, R2515.2
/OB: Q402.3, Q602.3, Q802.3, Q1002.3, Q1202.3, Q1402.3, Q1702.3, Q1902.3, Q2102.3, Q2302.3, R2514.2
/OUT_A0: U201.1, U202.1, U1501.31
/OUT_A1: U201.2, U202.2, U1501.30
/OUT_A2: U201.3, U202.3, U1501.29
/OUT_A3: U201.4, U1501.28
/OUT_B0: U203.1, U204.1, U1501.26
/OUT_B1: U203.2, U204.2, U1501.25
/OUT_B2: U203.3, U204.3, U1501.24
/OUT_B3: U203.4, U1501.23
/OUT_DIS_A: R201.1, U201.5, U202.5, U1501.47
/OUT_DIS_B: U203.5, U204.5, U1501.22
/RED: R1601.2, U1501.2
/R_ON: R301.2, U1501.14
/SW_STOP: R302.1, SW302.1, SW302.2, U1501.36
/UCELLS_SCL: U1501.20, U2604.5, U2605.5
/UCELLS_SDA_1: U1501.16, U2604.4
/UCELLS_SDA_2: U1501.15, U2605.4
/UMAX_1: R2603.1, R2614.2, U1501.8
/UMAX_2: R2607.1, R2615.2, U1501.11
/UMAX_3: R2612.1, R2616.2, U1501.12
/UMAX_4: R2613.1, R2617.2, U1501.13
/UMIN_1: R2620.1, R2624.2, U1501.3
/UMIN_2: R2621.1, R2625.2, U1501.4
/UMIN_3: R2622.1, R2626.2, U1501.5
/UMIN_4: R2623.1, R2627.2, U1501.6
/VDIFF: C2505.1, R2507.1, R2508.1, U1501.18, U2501.1
/VR2: C2501.2, C2502.2, R2104.2, R2204.2, R2502.1, R2503.1, R2504.1, U1501.21, U2604.6, U2605.6
/VS: D702.1, D802.1, D902.1, D1002.1, D1102.1, D1202.1, D1302.1, D1402.1, D1702.1, D1802.1, D1902.1, D2002.1, D2702.1, F301.2
GND: C301.2, C302.2, C303.2, C304.2, C305.2, C306.2, C308.2, C309.2, C310.2, C311.2, C312.2, C313.2, C314.2, C401.2, C403.2, C501.2, C503.2, C601.2, C603.2, C701.2, C703.2, C801.2, C803.2, C901.2, C903.2, C1001.2, C1003.2, C1101.2, C1103.2, C1201.2, C1203.2, C1301.2, C1303.2, C1401.2, C1403.2, C1501.2, C1502.2, C1503.2, C1504.2, C1505.2, C1701.2, C1703.2, C1801.2, C1803.2, C1901.2, C1903.2, C2001.2, C2003.2, C2101.2, C2201.2, C2301.2, C2401.2, C2701.2, C2703.2, C2801.2, C2803.2, D301.2, D302.2, D303.2, D2601.2, J1501.3, J2605.1, J2605.3, J2606.2, Q301.2, Q1601.2, Q1602.2, Q2601.2, Q2602.2, Q2603.2, Q2604.2, Q2605.2, Q2606.2, Q2607.2, Q2608.2, Q2609.2, Q2610.2, Q2611.2, R304.1, R306.2, R307.2, R1501.2, R1502.2, R2601.2, R2603.2, R2604.2, R2607.2, R2608.2, R2612.2, R2613.2, R2618.2, R2619.2, R2620.2, R2621.2, R2622.2, R2623.2, SW302.3, SW302.4, U201.8, U202.4, U202.8, U203.8, U204.4, U204.8, U301.2, U302.3, U302.6, U401.2, U501.2, U601.2, U701.2, U801.2, U901.2, U1001.2, U1101.2, U1201.2, U1301.2, U1401.2, U1501.9, U1501.41, U1701.2, U1801.2, U1901.2, U2001.2, U2101.2, U2201.2, U2301.2, U2401.2, U2601.5, U2601.7, U2603.4, U2604.2, U2605.2, U2701.2, U2801.2
unnamed: C306.1, U302.2
unnamed: C307.1, D302.1, L302.1, U302.8
unnamed: C307.2, U302.1
unnamed: C402.1, D401.1, U401.6
unnamed: C402.2, Q401.2, Q402.2, R403.1, U401.4
unnamed: C403.1, Q401.3, R404.1
unnamed: C502.1, D501.1, U501.6
unnamed: C502.2, Q501.2, Q502.2, R503.1, U501.4
unnamed: C503.1, Q501.3, R504.1
unnamed: C602.1, D601.1, U601.6
unnamed: C602.2, Q601.2, Q602.2, R603.1, U601.4
unnamed: C603.1, Q601.3, R604.1
unnamed: C702.1, D701.1, U701.6
unnamed: C702.2, Q701.2, Q702.2, R703.1, U701.4
unnamed: C703.1, Q701.3, R704.1
unnamed: C802.1, D801.1, U801.6
unnamed: C802.2, Q801.2, Q802.2, R803.1, U801.4
unnamed: C803.1, Q801.3, R804.1
unnamed: C902.1, D901.1, U901.6
unnamed: C902.2, Q901.2, Q902.2, R903.1, U901.4
unnamed: C903.1, Q901.3, R904.1
unnamed: C1002.1, D1001.1, U1001.6
unnamed: C1002.2, Q1001.2, Q1002.2, R1003.1, U1001.4
unnamed: C1003.1, Q1001.3, R1004.1
unnamed: C1102.1, D1101.1, U1101.6
unnamed: C1102.2, Q1101.2, Q1102.2, R1103.1, U1101.4
unnamed: C1103.1, Q1101.3, R1104.1
unnamed: C1202.1, D1201.1, U1201.6
unnamed: C1202.2, Q1201.2, Q1202.2, R1203.1, U1201.4
unnamed: C1203.1, Q1201.3, R1204.1
unnamed: C1302.1, D1301.1, U1301.6
unnamed: C1302.2, Q1301.2, Q1302.2, R1303.1, U1301.4
unnamed: C1303.1, Q1301.3, R1304.1
unnamed: C1402.1, D1401.1, U1401.6
unnamed: C1402.2, Q1401.2, Q1402.2, R1403.1, U1401.4
unnamed: C1403.1, Q1401.3, R1404.1
unnamed: C1702.1, D1701.1, U1701.6
unnamed: C1702.2, Q1701.2, Q1702.2, R1703.1, U1701.4
unnamed: C1703.1, Q1701.3, R1704.1
unnamed: C1802.1, D1801.1, U1801.6
unnamed: C1802.2, Q1801.2, Q1802.2, R1803.1, U1801.4
unnamed: C1803.1, Q1801.3, R1804.1
unnamed: C1902.1, D1901.1, U1901.6
unnamed: C1902.2, Q1901.2, Q1902.2, R1903.1, U1901.4
unnamed: C1903.1, Q1901.3, R1904.1
unnamed: C2002.1, D2001.1, U2001.6
unnamed: C2002.2, Q2001.2, Q2002.2, R2003.1, U2001.4
unnamed: C2003.1, Q2001.3, R2004.1
unnamed: C2102.1, D2101.1, U2101.6
unnamed: C2102.2, Q2101.2, Q2102.2, R2103.1, U2101.4
unnamed: C2202.1, D2201.1, U2201.6
unnamed: C2202.2, Q2201.2, Q2202.2, R2203.1, U2201.4
unnamed: C2302.1, D2301.1, U2301.6
unnamed: C2302.2, Q2301.2, Q2302.2, R2303.1, U2301.4
unnamed: C2402.1, D2401.1, U2401.6
unnamed: C2402.2, Q2401.2, Q2402.2, R2403.1, U2401.4
unnamed: C2503.1, R2504.2, U2501.7
unnamed: C2503.2, R2503.2, R2509.1, U2501.6
unnamed: C2504.2, R2505.2, R2506.2, R2510.1, R2512.1, U2501.3
unnamed: C2505.2, R2507.2, R2508.2, R2511.1, R2513.1, U2501.2
unnamed: C2510.1, D2502.1, R2513.2, R2515.1
unnamed: C2510.2, D2501.1, R2512.2, R2514.1
unnamed: C2702.1, D2701.1, U2701.6
unnamed: C2702.2, Q2701.2, Q2702.2, R2703.1, U2701.4
unnamed: C2703.1, Q2701.3, R2704.1
unnamed: C2802.1, D2801.1, U2801.6
unnamed: C2802.2, Q2801.2, Q2802.2, R2803.1, U2801.4
unnamed: C2803.1, Q2801.3, R2804.1
unnamed: D1601.1, D1602.1, D1603.1, D1604.1, D1605.1, D1606.1, D1607.1, D1608.1, D1609.1, D1610.1, D1611.1, D1612.1, D1613.1, D1614.1, D1615.1, D1616.1, Q1602.3
unnamed: D1601.2, D1601.3, R1603.1
unnamed: D1601.4, D1602.4, D1603.4, D1604.4, D1605.4, D1606.4, D1607.4, D1608.4, D1609.4, D1610.4, D1611.4, D1612.4, D1613.4, D1614.4, D1615.4, D1616.4, Q1601.3
unnamed: D1602.2, D1602.3, R1604.1
unnamed: D1603.2, D1603.3, R1605.1
unnamed: D1604.2, D1604.3, R1606.1
unnamed: D1605.2, D1605.3, R1607.1
unnamed: D1606.2, D1606.3, R1608.1
unnamed: D1607.2, D1607.3, R1609.1
unnamed: D1608.2, D1608.3, R1610.1
unnamed: D1609.2, D1609.3, R1611.1
unnamed: D1610.2, D1610.3, R1612.1
unnamed: D1611.2, D1611.3, R1613.1
unnamed: D1612.2, D1612.3, R1614.1
unnamed: D1613.2, D1613.3, R1615.1
unnamed: D1614.2, D1614.3, R1616.1
unnamed: D1615.2, D1615.3, R1617.1
unnamed: D1616.2, D1616.3, R1618.1
unnamed: D2601.1, J2606.3, R2628.1
unnamed: J2601.2, U2601.3
unnamed: J2601.4, U2601.1
unnamed: J2601.7, Q2604.3
unnamed: J2601.8, Q2602.3
unnamed: J2601.9, Q2601.3
unnamed: J2602.1, U2603.8
unnamed: J2602.2, U2603.7
unnamed: J2602.3, U2603.6
unnamed: J2602.4, U2603.5
unnamed: J2603.1, Q2603.3
unnamed: J2603.2, Q2605.3
unnamed: J2603.3, Q2606.3
unnamed: J2603.4, Q2607.3
unnamed: J2605.2, U2604.1
unnamed: J2605.4, U2605.1
unnamed: J2607.1, Q2608.3
unnamed: J2607.2, Q2609.3
unnamed: J2607.3, Q2610.3
unnamed: J2607.4, Q2611.3
unnamed: K301.2, Q301.3
unnamed: L301.2, U301.1
unnamed: Q301.1, R301.1
unnamed: Q401.1, Q402.1, R402.1, R403.2
unnamed: Q501.1, Q502.1, R502.1, R503.2
unnamed: Q601.1, Q602.1, R602.1, R603.2
unnamed: Q701.1, Q702.1, R702.1, R703.2
unnamed: Q801.1, Q802.1, R802.1, R803.2
unnamed: Q901.1, Q902.1, R902.1, R903.2
unnamed: Q1001.1, Q1002.1, R1002.1, R1003.2
unnamed: Q1101.1, Q1102.1, R1102.1, R1103.2
unnamed: Q1201.1, Q1202.1, R1202.1, R1203.2
unnamed: Q1301.1, Q1302.1, R1302.1, R1303.2
unnamed: Q1401.1, Q1402.1, R1402.1, R1403.2
unnamed: Q1601.1, R1601.1
unnamed: Q1602.1, R1602.1
unnamed: Q1701.1, Q1702.1, R1702.1, R1703.2
unnamed: Q1801.1, Q1802.1, R1802.1, R1803.2
unnamed: Q1901.1, Q1902.1, R1902.1, R1903.2
unnamed: Q2001.1, Q2002.1, R2002.1, R2003.2
unnamed: Q2101.1, Q2102.1, R2102.1, R2103.2
unnamed: Q2101.3, R2104.1
unnamed: Q2201.1, Q2202.1, R2202.1, R2203.2
unnamed: Q2201.3, R2204.1
unnamed: Q2301.1, Q2302.1, R2302.1, R2303.2
unnamed: Q2301.3, R2304.1
unnamed: Q2401.1, Q2402.1, R2402.1, R2403.2
unnamed: Q2401.3, R2404.1
unnamed: Q2601.1, R2609.1
unnamed: Q2602.1, R2610.1
unnamed: Q2603.1, R2614.1
unnamed: Q2604.1, R2611.1
unnamed: Q2605.1, R2615.1
unnamed: Q2606.1, R2616.1
unnamed: Q2607.1, R2617.1
unnamed: Q2608.1, R2624.1
unnamed: Q2609.1, R2625.1
unnamed: Q2610.1, R2626.1
unnamed: Q2611.1, R2627.1
unnamed: Q2701.1, Q2702.1, R2702.1, R2703.2
unnamed: Q2801.1, Q2802.1, R2802.1, R2803.2
unnamed: R303.1, R304.2, U302.5
unnamed: R305.2, R306.1, U301.3
unnamed: R401.1, U401.3
unnamed: R402.2, U401.5
unnamed: R501.1, U501.3
unnamed: R502.2, U501.5
unnamed: R601.1, U601.3
unnamed: R602.2, U601.5
unnamed: R701.1, U701.3
unnamed: R702.2, U701.5
unnamed: R801.1, U801.3
unnamed: R802.2, U801.5
unnamed: R901.1, U901.3
unnamed: R902.2, U901.5
unnamed: R1001.1, U1001.3
unnamed: R1002.2, U1001.5
unnamed: R1101.1, U1101.3
unnamed: R1102.2, U1101.5
unnamed: R1201.1, U1201.3
unnamed: R1202.2, U1201.5
unnamed: R1301.1, U1301.3
unnamed: R1302.2, U1301.5
unnamed: R1401.1, U1401.3
unnamed: R1402.2, U1401.5
unnamed: R1501.1, R1505.2, SW1501.C
unnamed: R1502.1, R1506.2, SW1502.C
unnamed: R1503.2, SW1501.8
unnamed: R1504.2, SW1502.8
unnamed: R1507.2, SW1501.4
unnamed: R1508.2, SW1502.4
unnamed: R1509.2, SW1501.2
unnamed: R1510.2, SW1502.2
unnamed: R1511.2, SW1501.1
unnamed: R1512.2, SW1502.1
unnamed: R1701.1, U1701.3
unnamed: R1702.2, U1701.5
unnamed: R1801.1, U1801.3
unnamed: R1802.2, U1801.5
unnamed: R1901.1, U1901.3
unnamed: R1902.2, U1901.5
unnamed: R2001.1, U2001.3
unnamed: R2002.2, U2001.5
unnamed: R2101.1, U2101.3
unnamed: R2102.2, U2101.5
unnamed: R2201.1, U2201.3
unnamed: R2202.2, U2201.5
unnamed: R2301.1, U2301.3
unnamed: R2302.2, U2301.5
unnamed: R2401.1, U2401.3
unnamed: R2402.2, U2401.5
unnamed: R2501.2, R2502.2, R2506.1
unnamed: R2618.1, U2601.2
unnamed: R2619.1, U2601.4
unnamed: R2701.1, U2701.3
unnamed: R2702.2, U2701.5
unnamed: R2801.1, U2801.3
unnamed: R2802.2, U2801.5
